MRE-Lab-UMD/arts/docs/decisions/07_simulation.md

# Decision 7 — Simulation

> **Role: decision record.** Moved verbatim from `AGENTS.md` on 2026-10-26 so the agent
> onboarding file stays short; `AGENTS.md` keeps a summary and links here.
> Words like "above", "below" or "this file" in the text refer to
> `AGENTS.md` as it was laid out before the move.

7. **Simulation:** Isaac Lab 3.0 with Newton physics backend (Linux Foundation, Apache-2.0),
   exposing the identical ROS 2 topic surface as the real patient cart; sim/real switch at the
   driver layer only. Haply has a first-party Isaac Lab integration for sim teleop.
