MRE-Lab-UMD/arts/docs/arts_architecture_proposal.html

# ARTS Software Architecture Proposal

From a dual-arm open resection system (ROS 2 Humble + OROCOS) to ARTS — a replicable, <$150k, fully open 3-arm laparoscopic platform for surgical autonomy research. Grounded in the v1.4 codebase inventory · August 2026.

## Key decisions at a glance

# | Decision | Recommendation | Why

1 | OROCOS RTT | Retire it. Propose ARTS as a ROS 2 / Slicer / NVIDIA stack. | rtt_ros2_integration has zero formal releases and a tiny community; the determinism it provides is reproducible with ros2_control chainable controllers, which every contributor already knows.
2 | Workspace & repo layout | Standard ROS 2 overlay chain: /opt/ros/humble (base underlay) → categorized middle overlays (ur_ros2_ws, flir_ros2_ws, slicer_ros2_ws, atracsys_ros2_ws, isaac_ros2_ws, oem_ros2_ws) → arts_ros2_ws on top → application overlays. Two trees: the git repo holds only recipes, .repos manifests, and first-party source; the ~142 GB of SDKs, third-party source, and build output lives in a machine-local mirror at ~/arts_local. Users source a single setup.bash. | Third-party stacks ship as their own workspaces and should stay in their native structure, pinned and rarely rebuilt. arts_ros2_ws stays small and fast to iterate; end users never see the middle-overlay details. Packages follow ROS 2 naming convention (arts_description, arts_driver, arts_controllers, …) — carts are deployment profiles, not code boundaries.
3 | ROS distro | Stay on ROS 2 Humble (Ubuntu 22.04) through 2026–27, then migrate directly to the 2026 LTS (Lyrical, supported to 2031) around summer 2027 once it has matured. Skip intermediate distros entirely. | Humble is in its most reliable years right now (2022–2027 support window) and matches every pinned driver in the current stack. One planned migration to a fresh 5-year LTS beats two migrations through Jazzy.
4 | Distribution | Docker-first (compose profile per cart) + a small host-setup script; keep a bare-metal install path generated from the same layers. | Clock discipline, udev, and NIC tuning cannot live in a container; everything else can and should.
5 | Time & recording | One PTP (IEEE 1588) clock domain; hardware-triggered stereo FLIR pair; everything into rosbag2 MCAP with device hardware timestamps. | Sync is decided at timestamp origin, not at save time. Once stamps are PTP-correct, "bridge to ROS then save" vs "save directly" stops mattering.
6 | Command API | Follow plain ROS 2 naming conventions (geometry_msgs / sensor_msgs types, ros2_control controller naming, REP-144-style topic names). No CRTK / dVRK vocabulary. | ARTS is deliberately independent of dVRK (no support path for da Vinci Xi/X/SP/5 instruments there, and no reliance on company donations). ROS 2 conventions are the common denominator that Slicer and NVIDIA tooling already speak.
7 | Simulation | Isaac Lab 3.0 with the Newton (Linux Foundation, Apache-2.0) physics backend, exposing the same ROS 2 interface as the real patient cart. | Sim/real switch happens at the driver layer; teleop and autonomy code cannot tell the difference.
8 | GPU vs RT kernel | Keep the RT control path free of any GPU dependency: GPU work (perception, encoding, learning) runs in separate processes or a second PC. PREEMPT_RT becomes an optional optimization, not a prerequisite. | NVIDIA drivers only gained working PREEMPT_RT compatibility in release 590.44.01 (late 2025) and it is still not officially supported. Decoupling means the system never depends on that fix.
9 | Dev methodology | Module-first, in Docker on the current PC. Every hardware module gets its own compose profile containing just its driver + ROS wrapper, a standard benchmark harness, and a committed baseline (rate mean ± std, CPU, RAM, disk/net I/O, drops). Integration climbs a ladder — module solo → pairs → full cart — re-running the identical benchmarks at every rung. | Isolating modules is how problems get located in big-system integration. Identical benchmarks at each rung make resource contention visible the moment it appears, instead of surfacing as mystery jitter in the full system.

## Target runtime architecture

Everything above the real-time core is soft real-time and replaceable; everything inside it runs in a single process on the patient-cart PC so all three arms share one deterministic update cycle.

Autonomy

BehaviorTree.CPP surgical workflows

Perception: stereo depth, SAM2, NIR, occupancy

Resection / task planners (from nephrectomy_ws)

Teleoperation (surgeon console)

2× Haply Inverse3 via Inverse Service (polled at 500 Hz)

Clutch, motion scaling, camera-frame mapping

Footswitches: energy, camera, record marks

Imaging (3D Slicer)

SlicerROS2 bridge

Pre/intra-op model registration

Plans published as ROS 2 targets

plain ROS 2 topics: geometry_msgs Cartesian targets, joint commands, jaw commands, measured states

Real-time control core — two rate-grouped controller_managers, SCHED_FIFO + CPU shielding (PREEMPT_RT optional)

500 Hz manager: both UR5e tool arms + instrument wrists — teleop follower → RCM + collision QP (pinocchio + proxsuite) → Ruckig → per-arm forward_position

125 Hz manager: UR5 CB3 camera arm. Rates cannot mix in one manager: ur_robot_driver's read() blocks on the RTDE stream, so a shared loop would be dragged to the slowest arm

Cross-manager joint states mirrored via RT-safe buffers for the collision QP (≤ 8 ms staleness — fine for collision margins, camera arm moves slowly)

Safety: arm–arm distance constraints as QP velocity dampers; e-stop aggregation as last resort

ros2_control hardware interfaces / device SDKs

Motion drivers

ur_robot_driver ×3 (RTDE: 500 Hz UR5e, 125 Hz UR5 CB3)

Tool drive: da Vinci X disc motors in custom adapters

Sensing drivers

2× FLIR via Spinnaker driver — PTP-stamped, HW-triggered pair

Laparoscope light source status

Aux / energy drivers

ESU + footswitch MCU (micro-ROS)

Vacuum (EPick), suction, irrigation, smoke evacuator

hardware

Patient cart hardware

Vention pedestal · 1× UR5 + 2× UR5e · da Vinci X laparoscope head + 2 FLIR cameras · 2× da Vinci X instruments via custom UR adapters · Karl Storz trainer box

Simulation twin

Isaac Lab 3.0 (Newton backend) spawns the same patient cart from the shared URDF/USD assets and exposes the identical ROS 2 topic surface. The teleop and autonomy layers connect to sim or real by launching a different driver profile — no code changes.

Data recording plane

A recorder taps every layer over ROS 2 into MCAP bags. All headers carry device hardware timestamps in one PTP clock domain, so offline alignment for SRT-H / LeRobot datasets is exact rather than approximate.

## Retiring OROCOS — what replaces each piece

Today the OROCOS mid-level controller (the v1.4 controller) runs a 100 Hz activity with Reflexxes Type II and KDL, deployed through a .ops script, and requires hand-built RTT typekits for every message plus a serialized single-worker build of orocos_ws. Each RTT feature maps cleanly onto a maintained mainstream replacement:

OROCOS feature used in v1.4 | Replacement in ARTS
TaskContext with 100 Hz periodic activity | controller_manager update loop at 250–500 Hz, SCHED_FIFO thread
Reflexxes Type II online trajectory generation | Ruckig (community version, actively maintained, jerk-limited OTG)
KDL FK / IK solvers | Pinocchio (analytic derivatives, needed anyway for the RCM/collision QP); ur_ikfast kept for analytic IK
RTT ports + typekits for zero-serialization dataflow | Chainable-controller interfaces inside one process; intra-process composable nodes elsewhere — no typekit generation ever again
deployer + .ops deployment scripts | ROS 2 launch + lifecycle nodes
OCL NetCDF reporting | rosbag2 MCAP
Lock-free RT-safe buffers | realtime_tools RealtimeBuffer / RealtimeBox

The nuance worth keeping What OROCOS actually bought you was deterministic in-process dataflow between components. Preserve that property architecturally — keep each servo pipeline in-process with chained controllers, in two rate-grouped controller_managers (500 Hz for the UR5e pair, 125 Hz for the CB3 camera arm; the UR driver's blocking RTDE read forbids mixing rates in one loop) — rather than by keeping RTT. Note that the orocos_kdl kinematics library is a separate, still-maintained project; using or dropping it is independent of dropping the RTT runtime.

Why not keep RTT? To be clear, OROCOS RTT and rtt_ros2_integration are fully open source (Apache-2.0) — the objection is purely maintenance and community. rtt_ros2_integration has no formal releases and a contributor pool of a handful of people, and it is the single biggest build complexity in the legacy installer today (serialized single-worker builds, hand-generated typekits for every message). For a release aimed at replication by other labs, every dependency should be apt/rosdep-installable and familiar to contributors.

Determinism, the NVIDIA driver, and the RT kernel Important decoupling: neither OROCOS nor ros2_control makes timing deterministic by itself — both just run SCHED_FIFO priority threads, and the jitter floor comes from the kernel underneath. So the RTT-vs-ros2_control choice is orthogonal to the NVIDIA-on-PREEMPT_RT problem. That problem now has three workable answers, in order of preference: (1) keep the control path GPU-free so the control PC does not need the NVIDIA kernel module at all (GPU perception on a second machine or a non-RT box); (2) run a single PC without PREEMPT_RT — a lowlatency/PREEMPT_DYNAMIC kernel with SCHED_FIFO threads and isolcpus CPU shielding holds sub-millisecond jitter, which servoj's lookahead smoothing absorbs easily at 500 Hz; (3) if hard RT is truly wanted on the GPU machine, NVIDIA driver 590.44.01+ contains the locking fix that previously deadlocked PREEMPT_RT (unsupported officially, but functional). ARTS should be designed to work under option 1 or 2 and treat PREEMPT_RT as an optional tuning step.

## Workspace layering & repo layout

ARTS keeps the proven v1.4 layering: a binary base underlay, categorized middle overlays for third-party stacks that ship in their own native layout, one first-party workspace on top, and per-project application overlays above that. End users never see the middle-overlay details — they source one setup.bash and build on top.

        application overlays — one per project / user
   imitation_learning_ws · cao_resection_ws · your_project_ws …
     └─ source ~/arts/arts_ros2_ws/install/setup.bash — nothing else needed
                              ▲
  arts_ros2_ws                all first-party arts_* packages (the top overlay)
                              ▲
  middle overlays — categorized, version-pinned, rarely rebuilt, built one per
     ur_ros2_ws · flir_ros2_ws · slicer_ros2_ws · atracsys_ros2_ws ·
     isaac_ros2_ws · oem_ros2_ws   (orocos_ws: retired)
     fresh `env -i` shell; each depends only on the base, never on a sibling
                              ▲
  /opt/ros/humble             base underlay (binary install)

A terminology note that matters for newcomers: in ROS 2, underlay conventionally means the base installation you build on top of (/opt/ros/humble). The categorized third-party workspaces in the middle are therefore called middle overlays — each is an overlay of the base and an underlay for arts_ros2_ws. Calling them "underlays" invites confusion with the base, so ARTS does not.

Three rules keep this modular instead of fragile: (1) middle overlays never depend on each other, so they rebuild independently — enforced by building each in a fresh env -i shell that sources only the base, exactly as the legacy installer does; (2) every middle overlay is defined by a version-pinned vcstool .repos manifest stored in the arts repo (under middle_overlay_ros2_wss/), so the whole chain is reproducible with one assemble script; (3) if a middle overlay is ever rebuilt, everything above it rebuilds too (ABI safety) — acceptable because pinned overlays change perhaps once a year. A bonus below in Distribution: each middle overlay maps one-to-one onto a cached Docker image layer.

There are two trees, and conflating them is the most common source of confusion. The git repo holds only text — install recipes, vcstool manifests, and first-party source (tens of MB). Everything heavy — OEM SDK trees, third-party source, and build artifacts, roughly 142 GB on the current development PC — lives in a machine-local tree at ~/arts_local that is reconstructed from those recipes and never committed. The two trees mirror each other by folder name, so ~/arts/oem_drivers/spinnaker/install.sh installs into ~/arts_local/oem_drivers/spinnaker-4.2.0.88/.

~/arts/                            ← THE GIT REPO — text only, tens of MB
├─ oem_drivers/                    manufacturer drivers/SDKs FOR PHYSICAL HARDWARE.
│  │                               Criterion is "a physical component exists", not license:
│  │                               Intel's librealsense is open source but belongs here;
│  │                               Slicer does not. Recipes only, never the SDK.
│  ├─ spinnaker/                   install.sh + VERSION   (FLIR cameras)
│  ├─ haply/                       install.sh + VERSION   (Inverse3 service, closed binary)
│  ├─ fusiontrack/                 install.sh + VERSION   (Atracsys optical tracker)
│  └─ zivid/ · clarius_cast/ · librealsense/
├─ open_source_software/           open-source NON-ROS software built from source
│  ├─ coal/ · pinocchio/ · proxsuite/ · ruckig/      build.sh + pinned VERSION each
│  └─ slicer/ · plus_toolkit/
├─ middle_overlay_ros2_wss/           third-party ROS 2 workspaces — manifests + build scripts
│  ├─ ur_ros2_ws/                   ur_ros2.repos       (UR driver + description, pinned tag)
│  ├─ flir_ros2_ws/               flir_ros2.repos   (FLIR spinnaker driver, image_common)
│  ├─ slicer_ros2_ws/              slicer_ros2.repos   (SlicerROS2)
│  └─ oem_ros2_ws/                 oem_ros2.repos      (loose wrappers with no ws of their own:
│                                                  zivid-ros, robotiq, realsense-ros,
│                                                  micro-ROS agent)
├─ arts_ros2_ws/                        THE top overlay — same shape as a middle overlay,
│  └─ src/                         builds in place (build/ install/ log/ gitignored)
│     ├─ arts_interfaces           msgs + srvs + actions (single package, ROS 2 convention)
│     ├─ arts_description          URDF+SRDF, tools, trainer box, calib; USD export for sim
│     ├─ arts_calibration          procedures + committed results → feeds arts_description
│     ├─ arts_driver               bringup launch + configs with per-component toggles
│     ├─ arts_controllers          chainable ros2_control: servo, RCM, teleop follower
│     ├─ arts_embedded/            FIRST-PARTY drivers — no third-party ROS driver exists
│     │  ├─ arts_dv_tool_driver        da Vinci X instrument disc drive (adapter motors)
│     │  ├─ arts_esu               micro-ROS bridge to ESU / footswitch MCU
│     │  └─ --- (haply bridge moved to oem_ros2_ws as haply_inverse3_ros2) WebSocket ↔ ROS 2 bridge
│     ├─ arts_utilities/
│     │  ├─ arts_kinematics        pinocchio models, ur_ikfast, instrument kinematics
│     │  ├─ arts_safety            arm–arm collision monitor/predictor, e-stop aggregation
│     │  ├─ arts_teleop            clutch, scaling, camera-frame mapping, input mapping
│     │  ├─ arts_record            MCAP recording profiles, footpedal-triggered marks
│     │  └─ arts_datasets          MCAP → LeRobot / SRT-H export + sync tooling
│     ├─ arts_sim                  Isaac Lab env, Newton assets, sim driver shim
│     └─ arts_slicer               SlicerROS2 modules, ultrasound, registration
├─ example_app_ros2_ws/                 ONE example application overlay on top of arts_ros2_ws
├─ deploy/                         module scripts, dockerfiles, compose, host_setup.sh, CI
├─ docs/                           build guide, BOM (<$150k), calibration, ADRs, benchmarks
└─ reference/                      gitignored symlinks; DELETE before open-sourcing

~/arts_local/                      ← MACHINE-LOCAL — ~142 GB, never in git
├─ oem_drivers/                    spinnaker-4.2.0.88/ · fusiontrack_v4.7.1/ · zivid-2.14.0/
├─ open_source_software/           coal/ · pinocchio/ · Slicer-Superbuild-Release/
└─ middle_overlay_ros2_wss/           ur_ros2_ws/{src,build,install,log} · flir_ros2_ws/{...}
                                   atracsys_ros2_ws/{...} · isaac_ros2_ws/{...} · oem_ros2_ws/{…}

Every non-package directory in the repo carries a COLCON_IGNORE marker so a colcon build from arts_ros2_ws does not descend into workspaces that must be built separately. This is mandatory in reference/ in particular: without it colcon follows the v1.4 reference symlink and attempts to build the entire previous-generation system. Note that COLCON_IGNORE is not .gitignore — those directories are fully git-tracked.

Two naming decisions worth stating explicitly. First, there is no arts_ur or arts_camera_flir package: UR and FLIR already have maintained third-party ROS drivers that arrive through the middle overlays, so what ARTS adds is launch and configuration, which lives in arts_driver. Only hardware with no ROS driver at all — the da Vinci disc drive, the ESU microcontroller, the Haply service bridge — earns a first-party package under arts_embedded/ (custom PCB + ESP32/micro-ROS bridges). Second, procedure-specific autonomy (perception, resection planners, task state machines) deliberately does not live in arts_ros2_ws; it belongs in application overlays. The prior system mixing ismr2024 and iros_2024_nephrectomy into its main repo is the pattern this avoids, and it is what makes the platform cleanly releasable.

### Dependency pinning policy

An unpinned open-source dependency will break the build between machines or overnight. This is not hypothetical for this lab: during prior development, collision-detection code that built successfully one evening failed the next morning on a second PC because coal's API had changed upstream in between. With more than a hundred libraries in the chain, tracking HEAD is not viable — the rule is to pin a release that is verified to build, and stay on it until a concrete problem forces a bump.

Dependency class | Pinned in | Example
Third-party ROS packages | middle_overlay_ros2_wss/<ws>/<ws>.repos | Universal_Robots_ROS2_Driver @ tag 2.2.15
Open-source non-ROS libraries | open_source_software/<lib>/VERSION | coal @ full commit hash
OEM SDKs | oem_drivers/<sdk>/VERSION + archive mirrored to ~/arts_local | Spinnaker @ 4.2.0.88
apt packages | deploy/modules/<module>.sh | libeigen3-dev=3.4.0-2ubuntu2
Python packages | requirements.txt beside the consuming package | torch==2.3.1

Two rules deserve emphasis. Never a branch: version: main or devel in a .repos file is banned; use a tag or, preferably, a full commit hash. Non-ROS C++ libraries are pinned too — coal, pinocchio, proxsuite, and Ruckig each get their own build recipe, and any transitive FetchContent(… GIT_TAG main) hidden inside a dependency's CMakeLists is overridden explicitly rather than inherited. Bumping a pin is a deliberate, benchmarked act: change the version, rebuild, re-run that module's benchmark, and commit the new baseline beside the old one.

### Cart naming

Keep the da Vinci-familiar names — they are instantly understood by every clinical and surgical-robotics reader: Patient Cart, Surgeon Console, Vision Cart. Inventing new names would cost recognition and buy nothing. In code they appear only as deployment profiles: cart-patient, cart-surgeon, cart-vision.

## Data recording & synchronization

### One clock domain, decided in hardware

Source | Rate | Sync mechanism | Timestamp origin
2× FLIR cameras (stereo laparoscope) | 30–60 fps | IEEE 1588 PTP slaves to the main PC; L/R pair fired by a shared hardware trigger line (or primary→secondary GPIO) | Camera hardware timestamp, already in PC clock domain
UR5e ×2 (RTDE) | 500 Hz | Driver stamps on receipt; jitter « 2 ms over dedicated NIC | PC receive time (fine at this rate)
UR5 CB3 (RTDE) | 125 Hz | Same | PC receive time
Haply Inverse3 ×2 | 500 Hz poll | Local service on the same PC → localhost latency ~0 | Bridge receive time
ESU / footswitch MCU | event + 100 Hz status | micro-ROS agent stamps at bridge | Agent receive time
Tool drive, EPick, pumps | ≤ 100 Hz | ROS 2 native | Node publish time

Answer to the "bridge to ROS and save, or just save?" question Bridge to ROS and record with rosbag2/MCAP. The thing that makes camera data hard to sync is not where you save it — it is where the timestamp comes from. With PTP-disciplined hardware stamps written into header.stamp by the Spinnaker ROS driver (as a composable node with intra-process transport, so frames are not copied), the bag is exactly as well-synchronized as a custom saver, and you keep one uniform recording, replay, and tooling path for every sensor in the system.

### Image bandwidth budget (the dominant cost)

Example at 1920×1200 @ 60 fps per camera — adjust to the exact FLIR model:

Format | Per camera | Both cameras | Verdict
Bayer 8-bit raw (debayer offline) | ~138 MB/s | ~276 MB/s | Preferred if a dedicated NVMe is available — lossless, trivially sustained by PCIe-4 SSDs
Debayered RGB8 | ~415 MB/s | ~830 MB/s | Never record this — 3× the data for zero information gain
Per-frame JPEG (GPU nvJPEG, q≈90) | 8–15 MB/s | 16–30 MB/s | The fallback when storage is constrained; still frame-random-access for training
H.264/H.265 (NVENC) | 4–8 MB/s | 8–16 MB/s | Smallest, but GOP structure hurts random access for imitation-learning dataloaders — archival copies only

### Recording architecture

Humble caveat: MCAP is supported but not the default rosbag2's MCAP plugin is officially released for Humble (ros-humble-rosbag2-storage-mcap) but is not part of the desktop/base variants and sqlite3 stays Humble's default — MCAP only became the default in Iron. So: install the plugin explicitly in every recording image and installer, always pass -s mcap to ros2 bag record, and put writer tuning (chunk size, zstd presets) in a shared --storage-config-file YAML. Playback needs no flag — rosbag2 auto-detects the format when reading.

Run two recorder processes into one session directory: bag A for robot/teleop/tool/energy state (~10 MB/s total — three arms at 500 Hz is trivial) and bag B for images, writing to a dedicated NVMe. MCAP with zstd for bag A; images stored uncompressed-by-rosbag (already Bayer or JPEG). Footpedal events publish "episode start/stop" marks that the recorder logs, so demonstrations segment themselves. Offline, arts_datasets aligns streams by hardware stamps and exports LeRobot-format episodes for SRT-H training.

## Distribution: Docker-first, host-setup second

The install-script pain from the prior system (OEM drivers pinned to specific releases, deps breaking overnight) is exactly what container images solve: users pull a frozen, tested image instead of re-resolving the world. But a container cannot provide kernel or clock discipline, so the design is a thin host layer plus fat images. The workspace layering maps one-to-one onto Docker image layers: each middle overlay (ur_ros2_ws, flir_ros2_ws, slicer_ros2_ws, oem_ros2_ws) is built in its own layer, so changing arts code rebuilds only the top layer while every middle overlay stays cached.

Stays on the host host_setup.sh

· CPU isolation (isolcpus for the control core); PREEMPT_RT kernel optional per decision 8

· ptp4l / phc2sys PTP grandmaster config

· NIC tuning: jumbo frames, receive buffers for GigE Vision

· udev rules (Haply, MCU serial, cameras), NVIDIA driver, nvidia-container-toolkit

Lives in containers GHCR images

· arts-control — net=host, CAP_SYS_NICE, /dev access; runs controller_manager

· arts-vision — NVIDIA runtime, Spinnaker, perception models

· arts-teleop / arts-recorder / arts-slicer (X11) / arts-sim (Isaac Lab)

· devcontainer for contributors, same base image as release

Redistribution check before release Spinnaker SDK, the Haply Inverse Service, and Zivid debs have OEM licenses that may not permit baking into a public image. The pattern that always works: the Dockerfile takes the vendor archive as a build argument, the repo documents the (free) download step, and your lab additionally keeps the current Software/-style vendored mirror for internal builds. Everything else should come from rosdep/apt with versions pinned in the image.

Keep a bare-metal install path, but generate it from the same Dockerfile layers (or document the Dockerfile as the canonical install recipe) so the two never drift apart the way the existing install docs and scripts already have.

### Module-first development workflow

The host stays minimal — kernel, NVIDIA driver, docker + nvidia-container-toolkit, PTP daemons — and every module is developed and benchmarked in its own compose profile with only its driver and ROS wrapper installed. The benchmark harness is a contract every driver package honors: a bench launch file plus an offline analyzer that reports achieved rate (mean ± std from MCAP stamps), CPU%, RSS, disk/network I/O, and drop count. Each result is committed under docs/benchmarks/ together with the image digest it ran on, so baselines are reproducible and regressions are diffable.

Integration then climbs a ladder, re-running the identical benchmarks at every rung: (1) module solo; (2) contention pairs — both cameras together, cameras + recorder, arms + recorder; (3) full patient cart; (4) full system with teleop and display. Each module also gets a resource budget up front (CPU cores from the isolcpus map, NIC allocation for GigE cameras, NVMe lane for the image bag) so a benchmark passes against its budget, not just in isolation.

PREEMPT_RT + NVIDIA + isolcpus — single-PC RT PROVEN (2026-08-05) Ubuntu Pro realtime kernel 5.15.0-1081-realtime installed as a second GRUB entry (generic 6.8.0-136 kept). NVIDIA driver 595.84 installed via apt install nvidia-driver-595 (userspace) + IGNORE_PREEMPT_RT_PRESENCE=1 DKMS bypass (made permanent in /etc/dkms/framework.conf; packages held via apt-mark hold). CPU isolation: isolcpus=4,5,10,11 nohz_full=4,5,10,11 rcu_nocbs=4,5,10,11 in GRUB. cyclictest result (5 min, CPU saturated + NVIDIA GPU rendering via PRIME offload): worst-case latency on isolated cores = 190 µs (avg 4–5 µs). That is 9.5% of the 500 Hz control period (2 ms) — well within budget. Decision 8 is answered: single-PC RT is the path forward; the two-PC and lowlatency-baseline fallbacks are retired. Production workstation with 16+ cores will have even more isolation headroom.

## New components not in the prior system

Software remote center of motion (RCM) arts_controllers

Formulate the servo loop as a small QP solved every cycle (pinocchio for kinematics + derivatives, proxsuite as solver): primary task tracks the tool-tip pose command; equality/soft constraint pins the instrument shaft to the calibrated cannula point; inequality constraints enforce joint limits, velocity limits, and arm–arm minimum distance. This is the standard modern replacement for the mechanically-constrained RCM of the da Vinci, runs comfortably at 250–500 Hz for three 6-DoF arms, and subsumes the current Reflexxes+KDL pipeline. Calibrate each RCM point from the cannula pose in the trainer box; a later refinement can estimate the true fulcrum from interaction forces.

Real-time arm–arm collision detection and prediction arts_safety

Approximate arms, adapters, and instrument shafts as capsules and query distances with coal (already vendored in the prior system) at ≥200 Hz. Predict by rolling joint states forward 100–300 ms at current velocities. Feed the results into the same QP as velocity-damper inequality constraints, so arms smoothly slow and deflect near contact instead of e-stopping — essential when all three elbows crowd over one trainer box while the surgeon's attention is at the tool tips. Hard e-stop remains as the escalation path.

Haptic teleoperation arts_teleop

The Inverse3 talks through the Haply Inverse Service — an OEM driver in the same category as Spinnaker or the UR controller firmware: a closed binary with a fully documented, open JSON-over-WebSocket API and open-source clients (Haply's Rust crate, Isaac Lab's Python HaplyDevice class). Every existing open wrapper sits on this service, so ARTS wraps it too: a thin bridge node polls it at 500 Hz — matched to the UR5e RTDE rate; the service's multi-kHz capability is unnecessary here since the service answers one state per command sent. The teleop layer implements clutching, 3:1–5:1 motion scaling, and mapping into the camera frame (so surgeon hand motion matches the laparoscope view), then publishes Cartesian target topics consumed by the RT core. Operator inputs beyond the cursor need an explicit, configurable mapping layer: VerseGrip buttons and a programmable 3-pedal footswitch are assigned to clutch, camera control, instrument switching, energy activation, and recording marks via a single mapping file (not hardcoded). Haply's first-party Isaac Lab integration gives sim teleop nearly for free. One dependency note for the docs: unlike the UR driver (open PC-side code over a documented wire protocol), the Inverse3 serial protocol is not public, so the service binary is a hard dependency.

da Vinci X instrument drive arts_dv_tool_driver

The custom UR–da Vinci adapters need a 4-motor disc drive per instrument. Expose it as an ordinary ros2_control joint interface (wrist pitch/yaw + jaw) chained into the same controller_manager so tool wrist and arm motion are coordinated in one cycle. ARTS defines and publishes its own instrument kinematics/coupling files for da Vinci X instruments — deliberately independent of dVRK, which has no support path for Xi/X/SP/5-generation tools. Existing dVRK definitions serve as a cross-check reference at most.

Energy / footswitch microcontroller arts_esu

Run micro-ROS on the MCU that sits between footswitches, the ESU back panel, and the PC. It publishes activation state (who requested energy, when it actually fired) and accepts activation commands from software — both directions land in the same bag, so imitation learning gets exact energy-on/off labels aligned with images and kinematics.

Stereo display path (GOOVIS HMD) surgeon console

The GOOVIS is an HDMI display: render the two FLIR streams side-by-side with a dedicated low-latency GStreamer/GPU path directly from the camera driver, not through RViz. Target glass-to-glass latency under ~100 ms; this path is independent of the recording path so display never competes with the recorder.

## Evaluation & benchmarking (ISMR target)

Every claim about the system gets a measurable, reproducible test — and where a comparison to dVRK or clinical systems is meaningful, the measurement method is independent of the software stack (external cameras, offline analysis of recorded stamps) so numbers are directly comparable across platforms.

### Benchmark anchors from SOTA open platforms

Platform | What they reported | ARTS comparison experiment
dVRK-Si (JHU/Vanderbilt, ISMR 2025) | PID control for all arms at 1.5 kHz with 0.01 ms std; digital current-loop step response < 1 ms. System/electronics paper — no task or latency metrics. | Report servo-loop rate + jitter with identical statistics; note the architectural caveat honestly (UR joint servos are internal to the arm — ARTS measures the command-path loop, dVRK-Si measures its own joint PID).
MOPS (SDU, ISMR 2021) | Vision-in-loop trajectory-following error 1.2 mm / 0.3° (UR5e arm), 2.7 mm / 0.7° (UR5 arm); autonomous needle pick-up 28/30; contact detection at 1.3 N. No latency, no RCM deviation reported. | Replicate their vision-in-loop protocol (stereo-tracked marker, taught trajectory) for a directly comparable end-to-end number — MOPS is ARTS's closest ancestor (UR arms + EndoWrist adapters + software RCM).
Open-source laparoscopic platform (under review, 2026) | Kinematic RCM deviation median 0.035–0.079 mm (phantom → in vivo); SPARC/LDLJ smoothness ≈ JIGSAWS experts; 85% autonomous policy success on bowel retraction. | Report kinematic RCM deviation with their exact definition, and SPARC/LDLJ computed from ARTS demo recordings against JIGSAWS + their published values.

ARTS differentiator measurements None of the three platforms report motion-to-motion teleoperation latency or externally measured (non-kinematic) accuracy. ARTS's external latency rig and the Atracsys fusionTrack ground-truth sessions are therefore both a contribution and a shield against the obvious reviewer question "your RCM number is kinematic — what is it physically?"

Category | Metric & method | Target
Latency | Teleop motion-to-motion: an external 240 fps camera films the Inverse3 handle and the robot tool in the same frame; latency = frame count between motion onsets. Stack-independent, same method used in dVRK literature. | ≤ 100 ms end-to-end
Latency | Glass-to-glass video: LED flash in the surgical scene filmed together with the HMD/monitor output by the same high-speed camera; frame-delta gives display-path latency. | ≤ 100 ms
Control | Servo loop health: cycle-time jitter (mean ± std) and deadline misses from controller_manager diagnostics over a 1 h session. | 0 missed deadlines; jitter < 10% of cycle period
Control | RCM deviation, two definitions: (a) kinematic — FK distance of the shaft line to the commanded RCM point, the same definition the open laparoscopic platform uses (their median: 0.035–0.079 mm); (b) physical — measured against the calibrated cannula including calibration error. Both logged through ≥ 30 min of teleoperation with drift slope. | (a) ≤ 0.1 mm median; (b) ≤ 1 mm RMS, ≤ 2 mm peak, no drift
Control | Master–slave tracking fidelity: RMS Cartesian error between the scaled master trajectory and the measured tool trajectory at nominal teleop speeds. | Report; goal ≤ 1 mm RMS
Control | Trajectory smoothness: SPARC and LDLJ computed offline from recorded teleop trajectories (downsampled to 5 Hz for fair comparison) against JIGSAWS expert demonstrations and the open platform's published values. Zero extra experiment time — pure post-processing of demo recordings. | Within the expert JIGSAWS range
Accuracy | Vision-in-loop trajectory following (MOPS protocol): stereo-tracked marker on the instrument, mean end-to-end pose error along a taught trajectory — directly comparable to MOPS's numbers. | ≤ 1.2 mm / 0.3° (match or beat MOPS's better arm)
Accuracy | External ground truth: Atracsys fusionTrack optical tracker (SDK already vendored in the v1.4 reference snapshot) physically measures tool-tip accuracy and RCM deviation — validates the kinematic numbers. | Report; no SOTA platform publishes this
Data pipeline | Recording rate consistency: per-topic achieved frequency (mean ± std) computed offline from MCAP hardware stamps over 30 min full-sensor-load sessions. Nominal rates are deliberately set at ~70% of each module's ceiling — consistent, not maximal. | ≥ 99% of nominal on every topic; zero dropped robot samples
Data pipeline | Synchronization accuracy: L/R stereo hardware-stamp skew (trigger-limited) and camera-to-robot clock alignment from PTP offset logs. | L/R skew < 1 ms; PTP offset < 1 µs
Safety | Collision avoidance: scripted near-collision teleop scenarios with three arms over the trainer box; log minimum inter-arm distance and contact count. | 0 contacts; minimum distance never below the QP margin
Human factors | NASA-TLX weighted workload after standardized FLS peg-transfer sessions, N ≥ 5 operators. | Weighted score ≤ 50
Human factors | Task performance: FLS peg-transfer completion time and error rate, compared against published dVRK and da Vinci teleop baselines. | Within the range of published dVRK results
Surgical function | Advanced da Vinci X instrument functions on ex vivo porcine tissue: monopolar cut & coag, bipolar coagulation, vessel sealing (with burst-pressure check), stapler firing (with staple-line leak check). | All four functions demonstrated with predefined per-task success criteria
System | Reliability and replicability: one uninterrupted 2 h teleop session without software restart; fresh-machine install from README by an outside user. | No restarts; teleop-in-sim within one day; BOM < $150k

Hard milestone: funder demo at T+2 months (~early Oct 2026) Teleoperated partial nephrectomy on a hydrogel phantom using a monopolar curved scissors and a bipolar fenestrated forceps. The recording pipeline must be complete beforehand so the demo is captured end-to-end as the example dataset for the ISMR paper. Demo-critical path = phases 0–4 (those two instruments + monopolar/bipolar energy specifically); simulation (phase 5) and the Docker release (phase 6) may slip past the demo. Stapler and vessel-sealing tests come after the demo.

Three-month path to an ISMR submission Month 1 — phases 0–2 plus the external latency rig (camera + LED, built once, reused forever). Month 2 — phases 3–4, closing with the funder demo; the automated metrics (latency, loop health, RCM drift, recording rates, sync) collect themselves during development sessions. Month 3 — NASA-TLX study, remaining tissue tests, writing, and the anonymized project page. If time runs short, the minimal publishable set is: system description + latency + recording/sync + RCM + the demo task with NASA-TLX; stapler and vessel-seal become qualitative demonstrations or future work.

Double-blind review logistics The private GitHub repo stays private and under a personal account — never linked from the submission. For review, publish an anonymized project page (fresh GitHub org/Pages with authors redacted, in the style of recent open-platform papers) and share code through an anonymized capsule (e.g. anonymous.4open.science). De-anonymize both after acceptance. Reviewers tracing a repo to the author is a known desk-rejection cause.
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
