MRE-Lab-UMD/arts/docs/dependency_pinning.md

# Dependency pinning policy — full text

> **Role: reference.** Moved verbatim from `AGENTS.md` on 2026-10-26 so the agent
> onboarding file stays short; `AGENTS.md` keeps a summary and links here.
> Words like "above", "below" or "this file" in the text refer to
> `AGENTS.md` as it was laid out before the move.

An unpinned open-source dependency WILL break the build between machines or overnight; this
happened in the prior system when coal's API changed between two builds a day apart. With >100
libraries in the chain, chasing HEAD is not viable. Pin a verified release and stay on it
until a concrete problem forces a bump.

Five rules, one home per dependency class:
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
