MRE-Lab-UMD/arts/docs/bom/bom.csv

cart | category | item | vendor | part_number | qty | unit_price_usd | price_basis | url | notes
patient | structure | 3-arm pedestal (assembled; arm mounts and casters included) | Vention | MF-RB-524807 | 1 | 16541.55 | list | https://vention.com/designs/robotic-surgery-triple-overhead-robot-stand-524807 | Vention parts-only price, no discount: 15,120.50 for the pedestal design plus 1,421.05 for the later pedestal reinforcement (PI, 2026-11-02), self-assembled like the 80/20 console. Order from the public design link rather than the ~300 individual parts. Excludes freight. The public design specifies 3x UR5e and its page total includes them; the arms are separate rows here.
patient | arm | UR5e 6-DoF arm with controller (500 Hz tool arm) | Kinova | 029348 | 2 | 30000.00 | quote | https://vention.com/parts/universal-robots-ur5e-collaborative-robot-arm-2445 | Typical standard quoted price per arm, subject to each institution's quote: the PI quoted the UR5e from four independent vendors, the designated channel among them, all at about 30,000 before any special discount; no vendor publishes an online price. Upper bound: 34,527.00 (Vention shows it for a UR5e marked Obsolete, 2026-11-02). Buy through the designated channel: see the Procurement constraints section of this directory's README. Ex-Works, freight extra.
patient | arm | UR5e 6-DoF arm with controller (camera arm) | Kinova | 029348 | 1 | 30000.00 | quote | https://vention.com/parts/universal-robots-ur5e-collaborative-robot-arm-2445 | Typical standard quoted price per arm, subject to each institution's quote: the PI quoted the UR5e from four independent vendors, the designated channel among them, all at about 30,000 before any special discount; no vendor publishes an online price. Upper bound: 34,527.00 (Vention shows it for a UR5e marked Obsolete, 2026-11-02). Buy through the designated channel: see the Procurement constraints section of this directory's README. Ex-Works, freight extra. ARTS measured the camera arm on an existing UR5 CB3 at 125 Hz, which is discontinued new; a reproducer buys a UR5e.
patient | adapter | UR flange to da Vinci X/Xi instrument adapter, 5 Dynamixel disc drives (printed body, machined shafts) | ARTS (first-party) | arts-tool-adapter | 2 | 1617.19 | estimate |  | First-party design (adapter collaborator, 2026-11-02). Per adapter: bought parts 1,236.79 (designer BOM: 5x Dynamixel XC330-M288-T, U2D2 + power hub, GT2 belts and pulleys, bearings, spring plungers, 5 V 10 A supply, fasteners and inserts; optional knob parts excluded), 10 CNC shafts in 316 stainless 365.40 (5 inner + 5 outer at the qty-15 instant-quote price; 608.95 at qty 1), printed parts ~15 of filament. Design and manufacturing package in hardware/tool_adapter/ (STEP, STLs, drawings, notes); stapler parts optional.
patient | instrument | da Vinci X/Xi large needle driver, 8 mm | Intuitive Surgical (used) | 471006 | 1 | 455.00 | used | https://www.ebay.com/itm/225942413010 | Used, expired-for-clinical-use instrument from the research surplus market (eBay); 455.00 is the per-instrument figure the PI set as fair from current listings 2026-11-02. Research use only, never clinical. Instrument geometry is vendor IP; ARTS publishes kinematics only.
patient | instrument | da Vinci X/Xi monopolar curved scissors, 8 mm | Intuitive Surgical (used) | 470179 | 1 | 455.00 | used | https://www.ebay.com/itm/225942413010 | Used, expired-for-clinical-use instrument from the research surplus market (eBay); 455.00 is the per-instrument figure the PI set as fair from current listings 2026-11-02. Research use only, never clinical. Instrument geometry is vendor IP; ARTS publishes kinematics only.
patient | instrument | da Vinci X/Xi fenestrated bipolar forceps, 8 mm | Intuitive Surgical (used) | 471205 | 1 | 455.00 | used | https://www.ebay.com/itm/225942413010 | Used, expired-for-clinical-use instrument from the research surplus market (eBay); 455.00 is the per-instrument figure the PI set as fair from current listings 2026-11-02. Research use only, never clinical. Instrument geometry is vendor IP; ARTS publishes kinematics only.
patient | instrument | da Vinci X/Xi permanent cautery hook, 8 mm | Intuitive Surgical (used) | 470183 | 1 | 455.00 | used | https://www.ebay.com/itm/225942413010 | Used, expired-for-clinical-use instrument from the research surplus market (eBay); 455.00 is the per-instrument figure the PI set as fair from current listings 2026-11-02. Research use only, never clinical. Instrument geometry is vendor IP; ARTS publishes kinematics only.
patient | optics | da Vinci Si stereo endoscope, 0 deg, 12 mm | Intuitive Surgical (used) | 370892 | 1 | 150.00 | used |  | Feeds the two machine-vision cameras through the first-party stereo optical coupling (laparoscope collaborator BOM, 2026-11-02). Bought used and expired for clinical use on eBay for about 150 (PI, 2026-11-02), research use only.
patient | optics | da Vinci Si light guide, bottom panel removed | Intuitive Surgical (used) | 951026 | 1 | 50.00 | used |  | Laparoscope collaborator BOM 2026-11-02. Bought used on eBay for about 50 (PI, 2026-11-02), research use only.
patient | optics | da Vinci Si camera head drape | Intuitive Surgical (used) | 420273 | 1 | TBD | used |  | Laparoscope collaborator BOM 2026-11-02. Used, research only; price to fill in.
patient | optics | 3D-printed parts of the stereo coupling (9 parts, hardware/laparoscope/printed/) | ARTS (first-party) | arts-camera-optics | 1 | 15.00 | estimate |  | About 390 cm3 of solid part volume, under 0.5 kg of PETG/PLA at full infill; filament cost. Printed in house.
patient | camera | Blackfly S USB3 colour camera 6.3 MP | Teledyne FLIR (via Edmund Optics 11-510) | BFS-U3-63S4C | 2 | 621.00 | list | https://www.edmundoptics.com/p/bfs-u3-63s4c-c-usb3-blackflyreg-s-color-camera/40166/ | BFS-U3-63S4C-C, the model on the cart and in every benchmark; the laparoscope STEP carries a different Blackfly S body (120S4) as a shape stand-in only. Edmund Optics price 2026-11-02.
patient | camera | 50 mm C Series fixed focal length lens | Edmund Optics | 59-873 | 2 | 500.00 | list | https://www.edmundoptics.com/p/50mm-c-series-fixed-focal-length-lens/16530 | One per camera (laparoscope collaborator BOM, 2026-11-02); price read on the vendor page 2026-11-02.
patient | optics | Right-angle kinematic mirror mount, 30 mm cage | Thorlabs | KCB1C | 2 | 165.48 | list | https://www.thorlabs.com/item/KCB1C | Stereo optical coupling, laparoscope collaborator BOM 2026-11-02; price read on the vendor page 2026-11-02.
patient | optics | 1 in protected silver mirror | Thorlabs | PF10-03-P01 | 2 | 60.20 | list | https://www.thorlabs.com/item/PF10-03-P01 | Stereo optical coupling, laparoscope collaborator BOM 2026-11-02; price read on the vendor page 2026-11-02.
patient | optics | 30 mm cage plate, SM1 and C-mount double bore | Thorlabs | CP36 | 2 | 25.93 | list | https://www.thorlabs.com/item/CP36 | Stereo optical coupling, laparoscope collaborator BOM 2026-11-02; price read on the vendor page 2026-11-02.
patient | optics | External C-mount to internal SM1 adapter | Thorlabs | SM1A9 | 2 | 22.88 | list | https://www.thorlabs.com/item/SM1A9 | Stereo optical coupling, laparoscope collaborator BOM 2026-11-02; price read on the vendor page 2026-11-02.
patient | optics | SM1 lens tube 0.30 in | Thorlabs | SM1L03 | 2 | 14.07 | list | https://www.thorlabs.com/item/SM1L03 | Stereo optical coupling, laparoscope collaborator BOM 2026-11-02; price read on the vendor page 2026-11-02.
patient | optics | Right-angle prism mirror, protected silver, 25 mm | Thorlabs | MRA25-P01 | 2 | 102.94 | list | https://www.thorlabs.com/item/MRA25-P01 | Stereo optical coupling, laparoscope collaborator BOM 2026-11-02; price read on the vendor page 2026-11-02.
patient | optics | Cage assembly rod 1/2 in, 6 mm | Thorlabs | ER05 | 14 | 5.99 | list | https://www.thorlabs.com/item/ER05 | Stereo optical coupling, laparoscope collaborator BOM 2026-11-02; price read on the vendor page 2026-11-02.
patient | optics | Male M30.5 to female C-mount adapter | Edmund Optics | 33-429 | 2 | 43.25 | list | https://www.edmundoptics.com/p/male-m305-to-female-c-mount/3126/ | Stereo optical coupling, laparoscope collaborator BOM 2026-11-02; price read on the vendor page 2026-11-02.
patient | optics | M3x10 flat head screw, 18-8 | McMaster-Carr | 92125A130 | 1 | 8.77 | list | https://www.mcmaster.com/92125A130/ | McMaster sells packs: qty is ONE pack covering the 8 needed (laparoscope collaborator BOM 2026-11-02); pack price read 2026-11-02.
patient | optics | M3x55 socket head screw, 18-8 | McMaster-Carr | 91292A027 | 1 | 9.04 | list | https://www.mcmaster.com/91292A027/ | McMaster sells packs: qty is ONE pack covering the 2 needed (laparoscope collaborator BOM 2026-11-02); pack price read 2026-11-02.
patient | optics | M3x25 flat head screw, 90 deg, 18-8 (small pack) | any (e.g. McMaster-Carr, Bolt Depot) | M3x25 ISO 10642 | 1 | 10.00 | estimate |  | 2 needed. McMaster 92125A709 comes only in packs of 2000 (175.56), so a small pack from any supplier is costed instead; estimate, verify when ordering.
patient | optics | M3x30 socket head screw, 18-8 | McMaster-Carr | 91292A022 | 1 | 6.14 | list | https://www.mcmaster.com/91292A022/ | McMaster sells packs: qty is ONE pack covering the 4 needed (laparoscope collaborator BOM 2026-11-02); pack price read 2026-11-02.
patient | optics | M3 heat-set insert, brass | McMaster-Carr | 94459A140 | 1 | 10.91 | list | https://www.mcmaster.com/94459A140/ | McMaster sells packs: qty is ONE pack covering the 14 needed (laparoscope collaborator BOM 2026-11-02); pack price read 2026-11-02.
patient | optics | 8-32 x 5/8 in socket head screw, 18-8 | McMaster-Carr | 92196A196 | 1 | 11.45 | list | https://www.mcmaster.com/92196A196/ | McMaster sells packs: qty is ONE pack covering the 4 needed (laparoscope collaborator BOM 2026-11-02); pack price read 2026-11-02.
patient | optics | 1/4-20 x 7/16 in socket head screw, 18-8 | McMaster-Carr | 92196A536 | 1 | 26.14 | list | https://www.mcmaster.com/92196A536/ | McMaster sells packs: qty is ONE pack covering the 2 needed (laparoscope collaborator BOM 2026-11-02); pack price read 2026-11-02.
patient | compute | Main PC: Dell Aurora ACT1250 desktop (Core Ultra 9 285K, RTX 5080 16 GB, 32 GB DDR5, 1 TB NVMe) | Dell | ACT1250 | 1 | 3679.99 | list | https://www.dell.com/en-us/search/ACT1250 | The production workstation every benchmark ran on (E2 19 us RT latency); keyboard and mouse included. dell.com 2026-11-02, configuration act1250_so_9 (1 TB), matching ours. No dedicated image NVMe is fitted (E4 wrote to the system disk).
patient | network | Ethernet switch, 8-port unmanaged gigabit (PC and three UR controllers) | D-Link | DGS-108 | 1 | 30.00 | estimate | https://www.dlink.com/en/products/dgs-108-8-port-gigabit-ethernet-switch | Typical street price; retailer pages could not be read automatically 2026-11-02, so verify when ordering. Any unmanaged gigabit switch works.
patient | safety | IDEM Viper safety relay, 2-channel 24 V, 7 N.O., ARM HOLD manual restart | AutomationDirect | SCR73-280005 | 1 | 456.00 | list | https://www.automationdirect.com/pn/SCR73-280005 | S22 monitored manual start. Six contacts to the three UR SI pairs. Seventh unused. No second relay. See docs/modules/safeguard_stop.md.
patient | safety | 24 VDC 2.5 A DIN supply for the HOLD relay coil only | AutomationDirect | PSL-24-060 | 1 | 69.00 | list | https://www.automationdirect.com/pn/PSL-24-060 | Does not power the robots. No ground screw; cap the mains green.
patient | safety | Polycarbonate enclosure, 10 x 8 x 6 in, opaque hinged cover | AutomationDirect | H10086HF-6P-P10 | 1 | 107.00 | list | https://www.automationdirect.com/pn/H10086HF-6P-P10 | Patient-cart box for the supply and the relay. One internal DIN rail.
patient | safety | DIN-rail kit for 8 in Integra Premium (pack of 2 rails) | AutomationDirect | DIN8-P10 | 1 | 21.00 | list | https://www.automationdirect.com/pn/DIN8-P10 | Use one rail. The second rail stays spare.
patient | safety | 18 AWG 4-conductor flexible control cable | AutomationDirect | PMTC-18U-4BK-1 | 50 | 0.88 | list | https://www.automationdirect.com/pn/PMTC-18U-4BK-1 | 50 ft reel, fully used: two supervisor-desk runs, three short robot pieces, supply jumpers. Price is per foot.
patient | safety | Mains cord, SJOOW 18 AWG, 3 conductors, black/white/green | AutomationDirect | H11131803-1 | 20 | 0.72 | list | https://www.automationdirect.com/pn/H11131803-1 | 20 ft is the catalog minimum. Black to supply L | white to N | green taped. Price is per foot. An existing black/white/green cord is electrically compatible.
patient | safety | NEMA 5-15P plug, 15 A, 125 V | AutomationDirect | BRY5266NP | 1 | 13.00 | list | https://www.automationdirect.com/pn/BRY5266NP | Plug end: black brass | white silver | green to the green screw.
tower | energy | Electrosurgical unit, monopolar + bipolar | DRE (used) | ASG-300 | 1 | 1200.00 | used |  | Bought used on eBay, research use only (PI, 2026-11-02). Interfaced through the first-party ESU-TAP interposer below.
tower | energy | ESU-TAP PCB interposer with ESP32 (micro-ROS) | ARTS (first-party) | arts-esu-tap | 1 | 62.22 | list |  | Custom. Sense-then-forward footswitch plus software energy activation; both logged. Board revision v2. 62.22 = JLCPCB public online price 2026-11-02 (bare PCB 1.008 + SMD assembly incl. parts 20.388; the LCSC-numbered SMD BOM ships with the board design) + hand-installed and panel parts at DigiKey qty-1 list 2026-11-02, 40.82: ESP32-DevKitC-32E 10.00; Phoenix 1715747 (MKDS 1,5/4-5,08) 2x2.28; Phoenix 1715734 (MKDS 1,5/3-5,08) 2x1.71; Same Sky PJ-102AH 0.83; TE 206430-1 panel receptacle 2x6.06; TE 66105-4 socket contact 8x2.00. No enclosure: the board runs bare, as the camera sync box does. The 5 V supply is the next row. Still to confirm: whether the 20.388 assembly figure already includes the PCB is to be confirmed.
tower | energy | 5 V wall adapter for the ESU-TAP relay rail (5.5 x 2.1 mm barrel, centre positive) | Same Sky (Bel Power Solutions) | SWI12-5-N-P5 | 1 | 20.51 | list | https://www.digikey.com/en/products/result?keywords=SWI12-5-N-P5 | Any regulated 5 V, >= 1 A, centre-positive 5.5 x 2.1 mm adapter works: the six 5 V relay coils draw well under 1 A, and the ESP32 is powered over USB. DigiKey qty-1 price 2026-11-02; stock and plug details not confirmed on the page, so check them when ordering.
tower | structure | Laparoscopic video tower cart | Karl Storz (used) | TBD | 1 | 250.00 | used |  | Used, bought on eBay for 250.00 (PI, 2026-11-02); carries monitor 4 (tower view) and the support equipment. Any equivalent cart works.
tower | display | Monitor 4 (tower view), on the tower cart | Amazon | B0CMXK5QDD | 1 | 130.00 | estimate | https://www.amazon.com/dp/B0CMXK5QDD | How the tower monitor was acquired is not recorded; costed as the supervisor monitor model, which does the job (any HDMI 1080p 60 Hz monitor; E7 glass-to-glass was measured on the tower monitor at 60 Hz).
tower | optics | Laparoscopic light source | Luxtec (used) | LX300 | 1 | 250.00 | used |  | Bought used on eBay, research use only (PI, 2026-11-02).
tower | support | Smoke evacuator | Bovie (used) | SmokeShark II SE02 (100-120 V) | 1 | 350.00 | used | https://www.ebay.com/itm/920018283610 | Used on eBay, 349.99 rounded (PI, 2026-11-02), without filter; research use only. The filter is a consumable, next row.
tower | support | Smoke evacuator filter, 35 h | Bovie | SF35 | 1 | 243.44 | list | https://mfimedical.com/products/bovie-smoke-evacuator-filter-35-hr | Consumable, replaced as it wears; one included in the system cost (MFI Medical, new, 2026-11-02).
tower | support | Endoscopic flushing pump (irrigation) | Olympus (used) | OFP | 1 | 130.00 | used |  | Bought used on eBay, research use only (PI, 2026-11-02).
tower | support | Medical suction pump | TBD (used) | TBD | 1 | 110.00 | used | https://www.ebay.com/itm/236502488431 | Bought used on eBay, research use only (PI, 2026-11-02).
console | structure | Surgeon console frame, 80/20 40-series T-slot (extrusions, plates, fasteners, casters, HDPE panels) | 80/20 | IdeaBuilder design ARTS_Surgeon_Console_V5 | 1 | 1504.27 | list |  | 80/20 IdeaBuilder bill of materials 2026-09-23 (cut and machined parts), self-assembled. Design files machine-local for now (description catalog, 7_surgeon_console).
console | haptics | Haply Inverse3 Developer Kit (Inverse3, desk clamp, VerseGrip stylus, power adaptor, USB cables); one right- and one left-handed | Haply Robotics | Inverse3 Developer Kit | 2 | 5500.00 | quote | https://haply.co/inverse3 | Haply's standard per-kit price (5,500.00), subject to each institution's quote; Haply publishes no web price. A discount offered to the PI is not used. Includes the VerseGrip.
console | haptics | Grip add-on for the VerseGrip (uses its Hall sensor) | ARTS (first-party, collaborator A) | TBD | 2 | TBD | estimate |  | Design and parts from collaborator A, to be collected.
console | display | Stereo head-mounted display, GOOVIS G3 family (plain HDMI stereo) | GOOVIS | G3 Max | 1 | 1199.00 | list | https://goovis.com/products/goovis-g3max | GOOVIS G3 Max basic set, the unit on the console; list price 1,199.00 (goovis.com and Amazon list, 2026-11-02).
console | structure | Armrest cushion for the console arm rest | EdgeRest (Amazon) | B0FY9T1YTP | 1 | 60.00 | list | https://www.amazon.com/dp/B0FY9T1YTP | PostureUp L-shaped armrest pad (PI, 2026-11-02).
console | input | Programmable 3-pedal USB footswitch (teleop pedals) | Kinesis | Savant Elite2 FP30A | 1 | 229.00 | list | https://kinesis-ergo.com/shop/savant-elite2-triple-pedal/ | Clutch / camera / instrument switch / record marks per the input mapping file. kinesis-ergo.com 2026-11-02.
console | energy | Monopolar ESU footswitch (CUT/COAG) for the ASG-300 | Bovie (used) | BV-1253B | 1 | 499.00 | used | https://www.ebay.com/itm/154211251093 | Bought used on eBay (PI, 2026-11-02); read by the ESU-TAP board.
console | energy | Bipolar ESU footswitch for the ASG-300 | Bovie (used) | BV-1254B | 1 | 240.00 | used | https://www.ebay.com/p/706577766 | Bought used on eBay (PI, 2026-11-02).
supervisor | display | Monitors 1 and 2 (operator GUI, RViz) | Amazon | B0CMXK5QDD | 2 | 130.00 | list | https://www.amazon.com/dp/B0CMXK5QDD | The supervisor monitors (PI, 2026-11-02). Keyboard and mouse come with the main PC.
supervisor | safety | Gray 2-hole 22 mm button box, ARM HOLD plus RESET | AutomationDirect | SA106-40SL | 1 | 11.50 | list | https://www.automationdirect.com/pn/SA106-40SL | The single ARM HOLD station at the supervisor desk. NC blocks side by side.
supervisor | safety | Blue 22 mm latching button, ARM HOLD | AutomationDirect | GCX3194-24L | 1 | 25.00 | list | https://www.automationdirect.com/pn/GCX3194-24L | Remove the stock NO block. Fit two NC blocks side by side.
supervisor | safety | NC contact block pack of 2 | AutomationDirect | ECX1030-2 | 1 | 8.75 | list | https://www.automationdirect.com/pn/ECX1030-2 | One pack gives the two NC blocks for the blue button.
supervisor | safety | Legend plate OFF-ON | AutomationDirect | ECX1670-B16 | 1 | 3.50 | list | https://www.automationdirect.com/pn/ECX1670-B16 | Overlay ARM HOLD. Do not use a red STOP legend.
supervisor | safety | Green 22 mm momentary button, RESET, 1 NO | AutomationDirect | GCX3102 | 1 | 5.75 | list | https://www.automationdirect.com/pn/GCX3102 | Keep its stock NO block.
supervisor | safety | Legend plate RESET | AutomationDirect | ECX1670-B38 | 1 | 4.50 | list | https://www.automationdirect.com/pn/ECX1670-B38
lab | structure | Supervisor table | any | TBD | 1 | TBD | TBD |  | Any table; standard furniture a lab already has, NOT in the system cost (PI, 2026-11-02).
lab | environment | Laparoscopic trainer box | Karl Storz | TBD | 1 | TBD | TBD |  | Standard lab equipment a surgical-robotics group already has; listed so the setup is complete, NOT in the system cost (PI, 2026-11-02).
lab | environment | Cannula / trocar | TBD | TBD | 3 | TBD | TBD |  | Standard lab equipment a surgical-robotics group already has; listed so the setup is complete, NOT in the system cost (PI, 2026-11-02).
lab | metrology | fusionTrack optical tracker | Atracsys | TBD | 1 | TBD | TBD |  | NOT part of the ARTS build. Used only for the external ground-truth accuracy session; exclude from the system cost total.
lab | metrology | High-speed camera (240 fps) for the latency rig | TBD | TBD | 1 | TBD | TBD |  | NOT part of the ARTS build. A modern phone at 240 fps is sufficient.
