MRE-Lab-UMD/arts/hardware/laparoscope/printed/prism_mount_bottom.stl

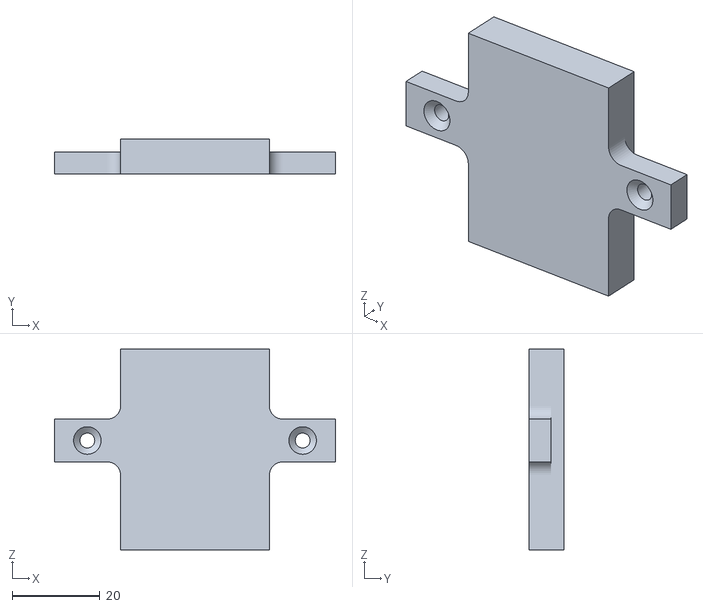
[picture p3: CAD file, 2026-11-10]
hardware/laparoscope/printed/prism_mount_bottom.stl
64.2 x 7.93 x 45.9
