MRE-Lab-UMD/arts/hardware/tool_adapter/machined/inner_shaft.step

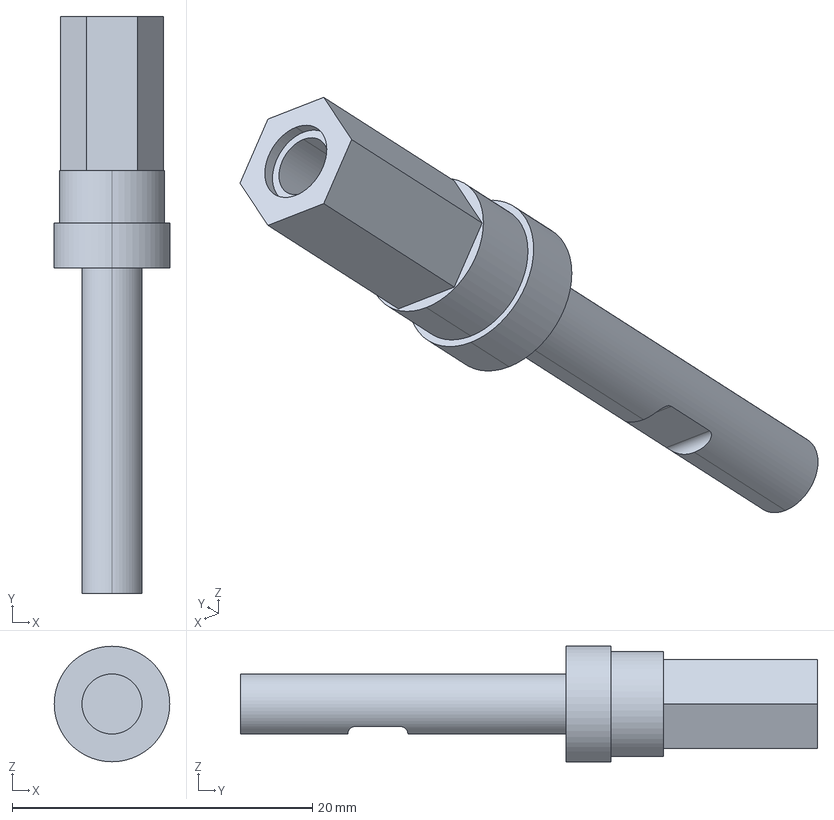
[picture p4: CAD file, 2026-11-10]
hardware/tool_adapter/machined/inner_shaft.step
7.70 x 38.4 x 7.70 mm
