MRE-Lab-UMD/arts/hardware/tool_adapter/printed/06_Snap_Clips.stl

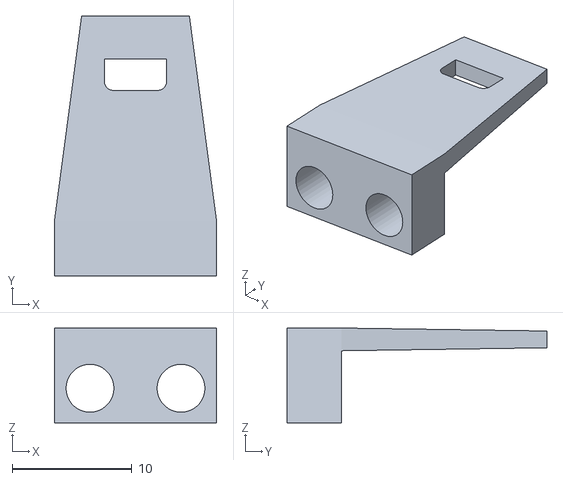
[picture p5: CAD file, 2026-11-10]
hardware/tool_adapter/printed/06_Snap_Clips.stl
13.6 x 21.7 x 7.93
