MRE-Lab-UMD/arts/hardware/laparoscope/printed/prism_mount_top.stl

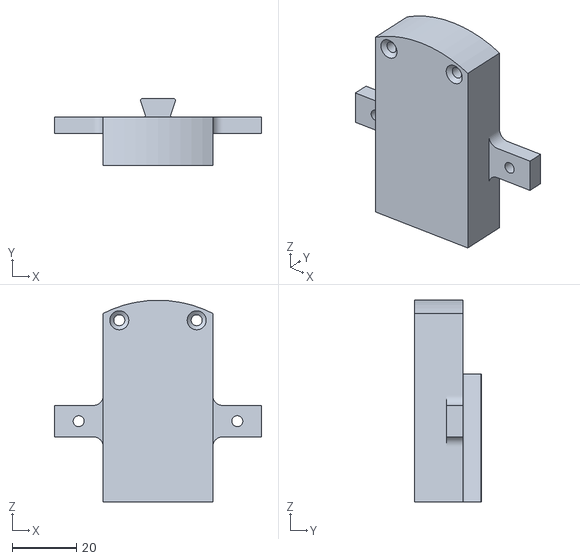
[picture p6: CAD file, 2026-11-10]
hardware/laparoscope/printed/prism_mount_top.stl
64.2 x 20.7 x 62.5
