MRE-Lab-UMD/arts/hardware/tool_adapter/machined/outer_shaft.step

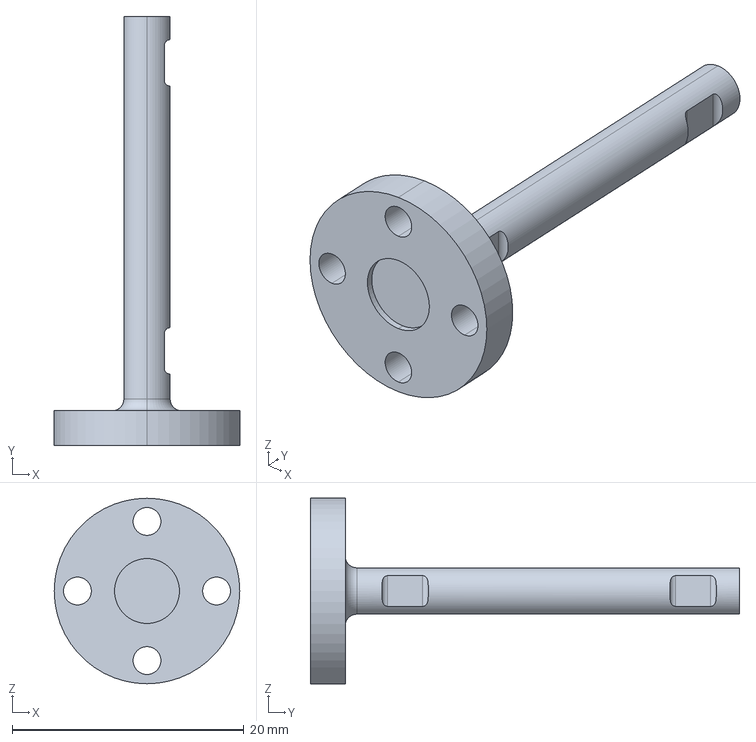
[picture p7: CAD file, 2026-11-10]
hardware/tool_adapter/machined/outer_shaft.step
16.0 x 37.0 x 16.0 mm
