MRE-Lab-UMD/arts/hardware/tool_adapter/printed/OPTIONAL_03_Top_Securing_Forceps_Scissors.stl

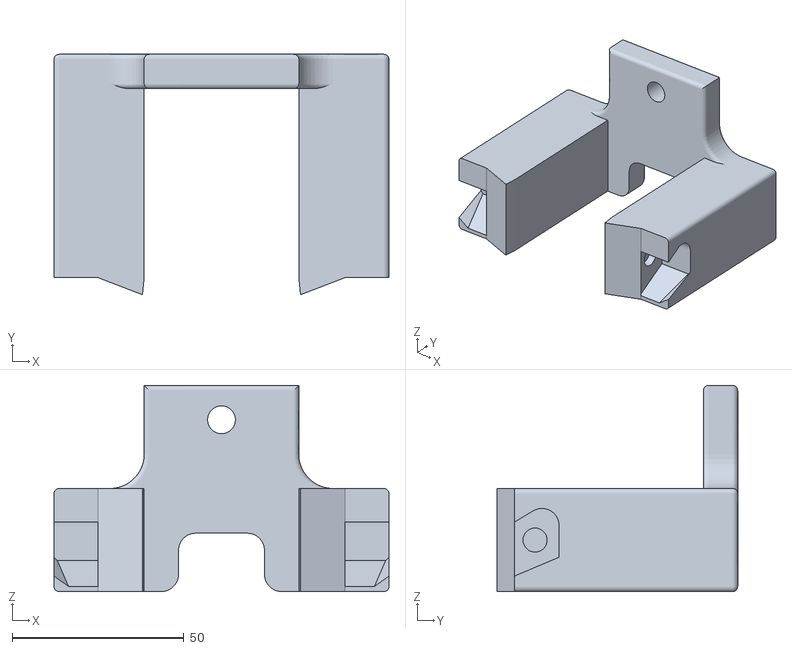
[picture p8: CAD file, 2026-11-10]
hardware/tool_adapter/printed/OPTIONAL_03_Top_Securing_Forceps_Scissors.stl
97.5 x 70.0 x 60.0
