MRE-Lab-UMD/arts/hardware/laparoscope/printed/adapter_for_light_cable_mount.stl

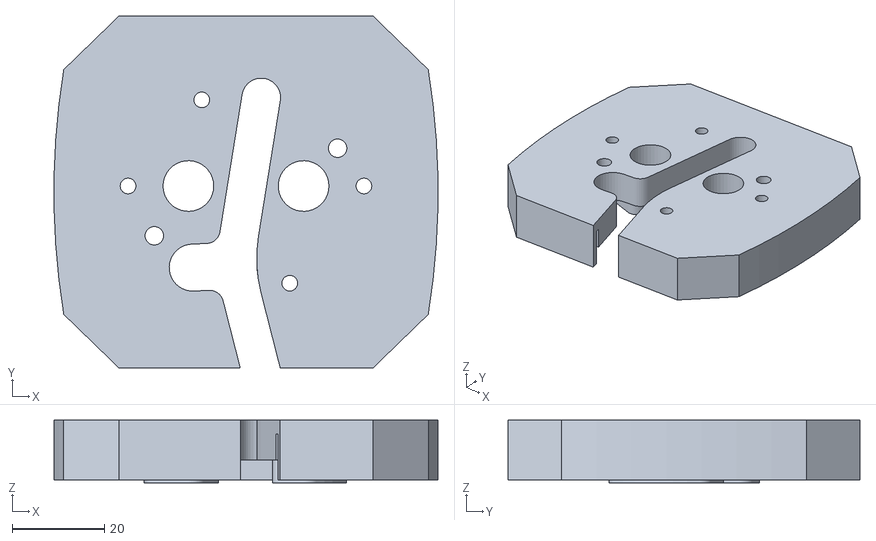
[picture p9: CAD file, 2026-11-10]
hardware/laparoscope/printed/adapter_for_light_cable_mount.stl
83.3 x 76.4 x 13.6
