MRE-Lab-UMD/arts/hardware/tool_adapter/printed/22_Motor_Twist_Top.stl

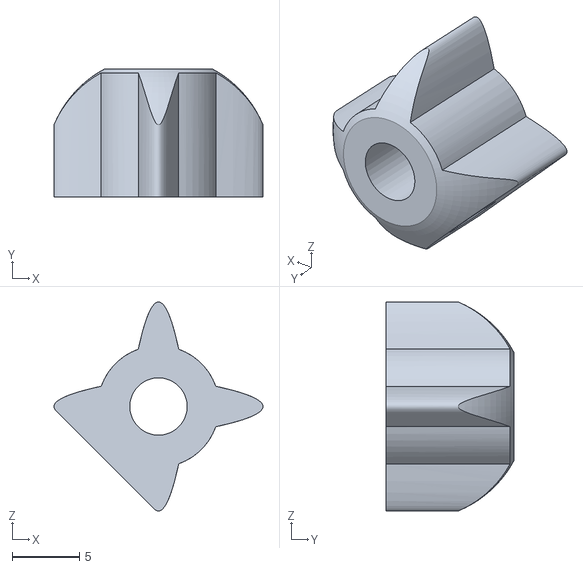
[picture p10: CAD file, 2026-11-10]
hardware/tool_adapter/printed/22_Motor_Twist_Top.stl
15.5 x 9.50 x 15.5
