MRE-Lab-UMD/arts/hardware/laparoscope/printed/prism_mount_left_plate.stl

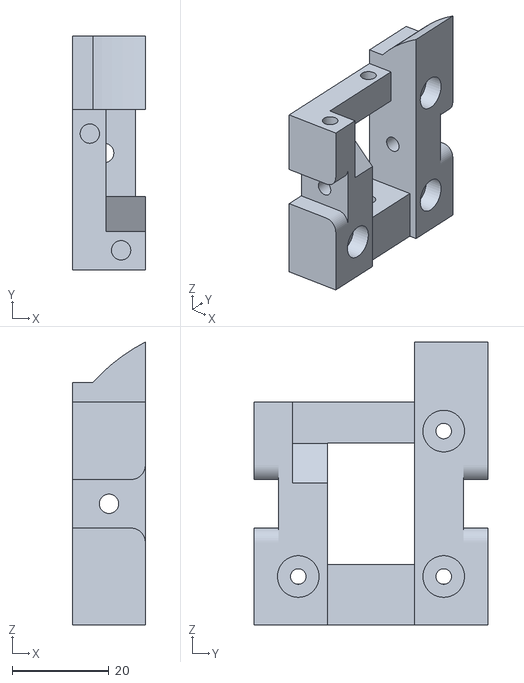
[picture p11: CAD file, 2026-11-10]
hardware/laparoscope/printed/prism_mount_left_plate.stl
15.0 x 48.3 x 58.4
