MRE-Lab-UMD/arts/hardware/laparoscope/printed/ur5_mount.stl

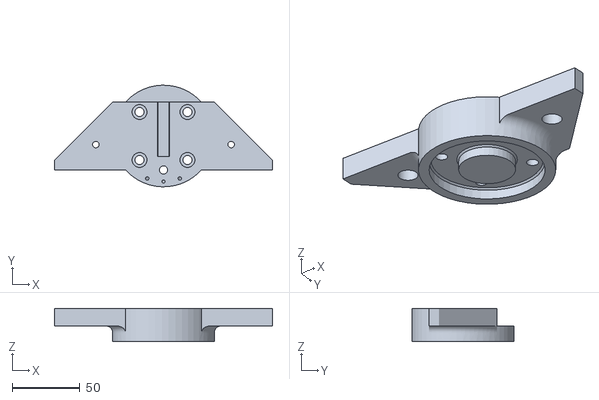
[picture p13: CAD file, 2026-11-10]
hardware/laparoscope/printed/ur5_mount.stl
160.7 x 75.0 x 24.5
