MRE-Lab-UMD/arts/hardware/tool_adapter/printed/OPTIONAL_13_Rod_Support_Base_Clip_stapler.stl

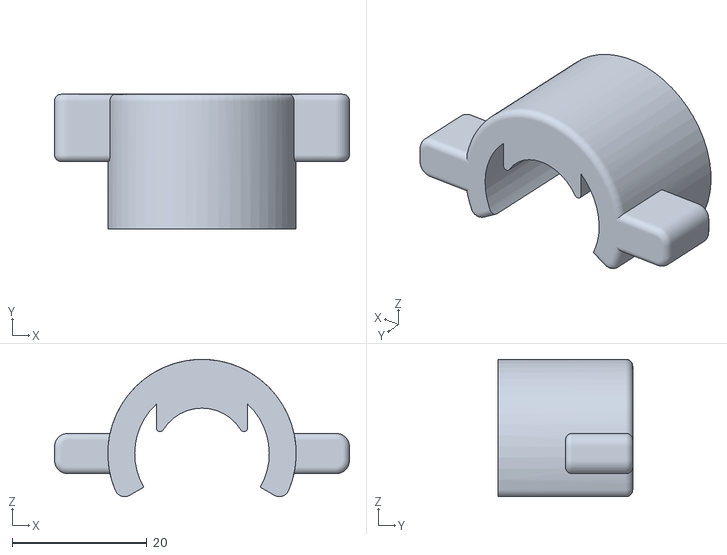
[picture p14: CAD file, 2026-11-10]
hardware/tool_adapter/printed/OPTIONAL_13_Rod_Support_Base_Clip_stapler.stl
43.8 x 20.0 x 20.4
