MRE-Lab-UMD/arts/hardware/tool_adapter/printed/04_Disk_Plate_0.5.stl

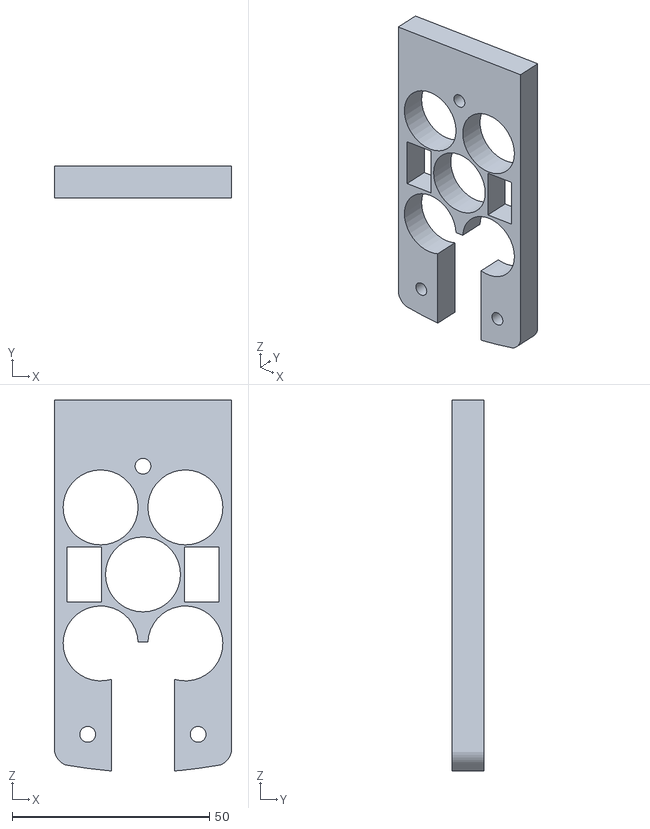
[picture p15: CAD file, 2026-11-10]
hardware/tool_adapter/printed/04_Disk_Plate_0.5.stl
45.0 x 8.10 x 94.1
