MRE-Lab-UMD/arts/hardware/laparoscope/printed/light_cable_holder_left.stl

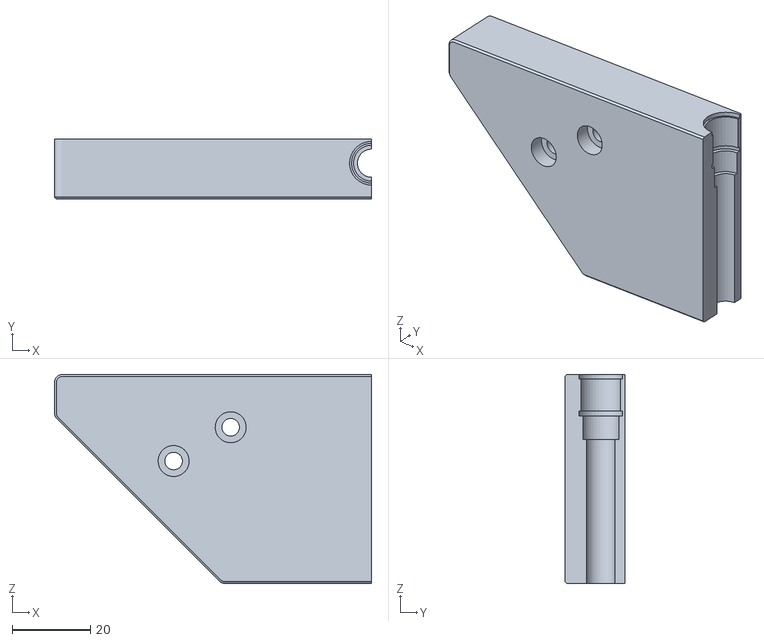
[picture p16: CAD file, 2026-11-10]
hardware/laparoscope/printed/light_cable_holder_left.stl
81.1 x 15.4 x 53.5
