MRE-Lab-UMD/arts/hardware/tool_adapter/printed/05_Engagement_Disks.stl

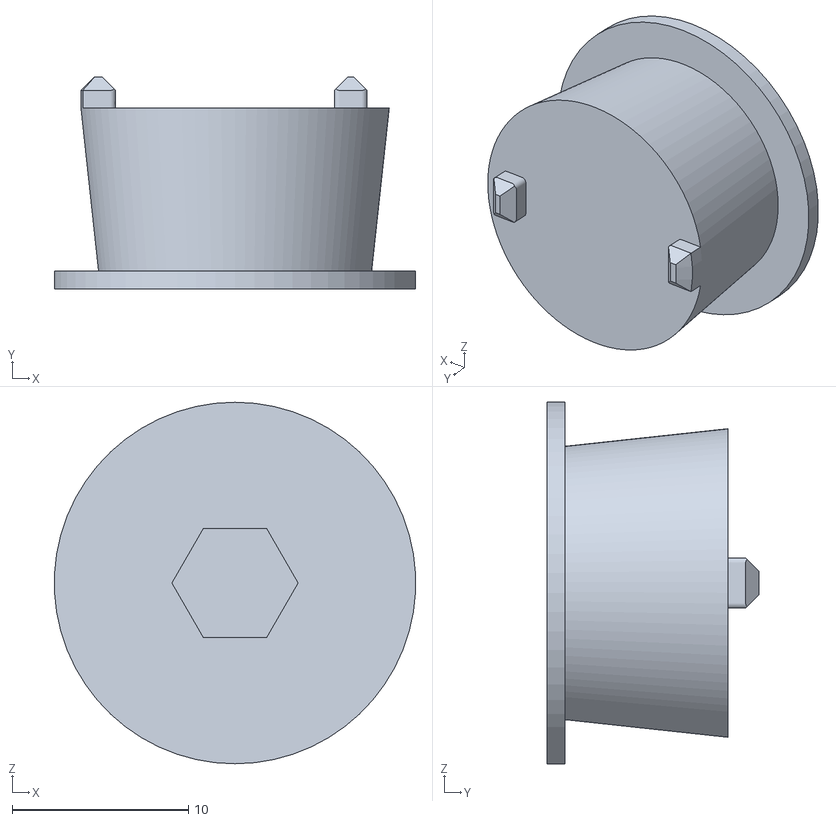
[picture p17: CAD file, 2026-11-10]
hardware/tool_adapter/printed/05_Engagement_Disks.stl
20.5 x 12.0 x 20.5
