MRE-Lab-UMD/arts/hardware/laparoscope/printed/light_cable_holder_right.stl

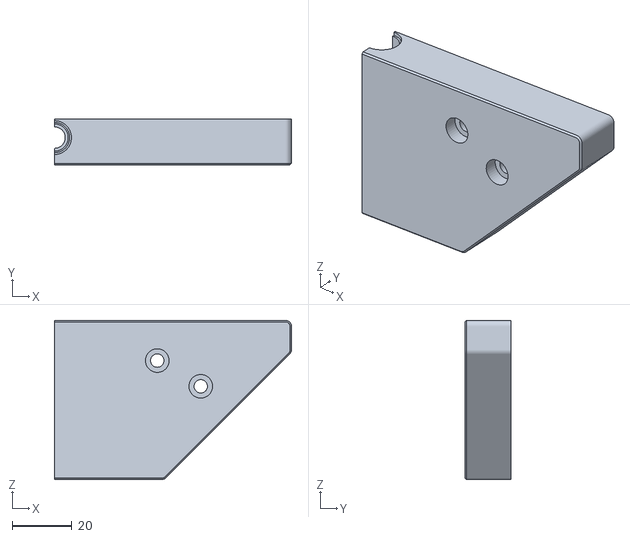
[picture p18: CAD file, 2026-11-10]
hardware/laparoscope/printed/light_cable_holder_right.stl
79.6 x 15.4 x 53.5
