MRE-Lab-UMD/arts/hardware/tool_adapter/printed/17_Motor_Holder_Outer.stl

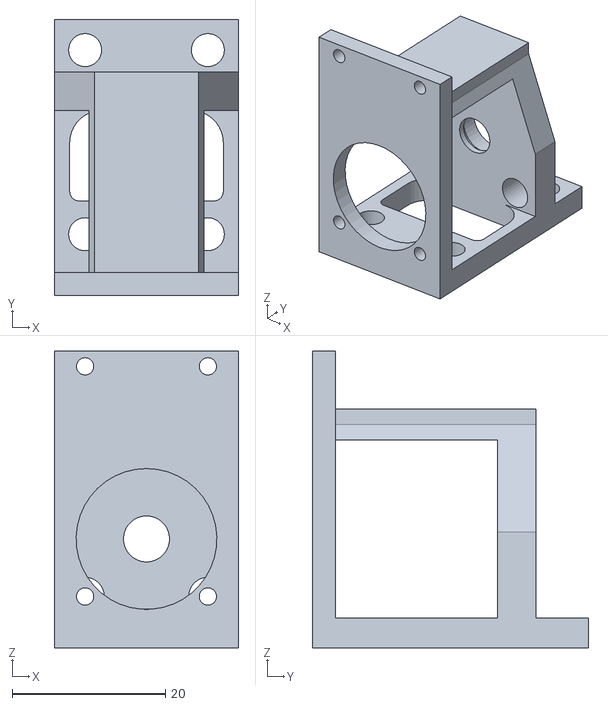
[picture p19: CAD file, 2026-11-10]
hardware/tool_adapter/printed/17_Motor_Holder_Outer.stl
24.0 x 36.0 x 38.7
