MRE-Lab-UMD/arts/hardware/laparoscope/printed/prism_mount_back.stl

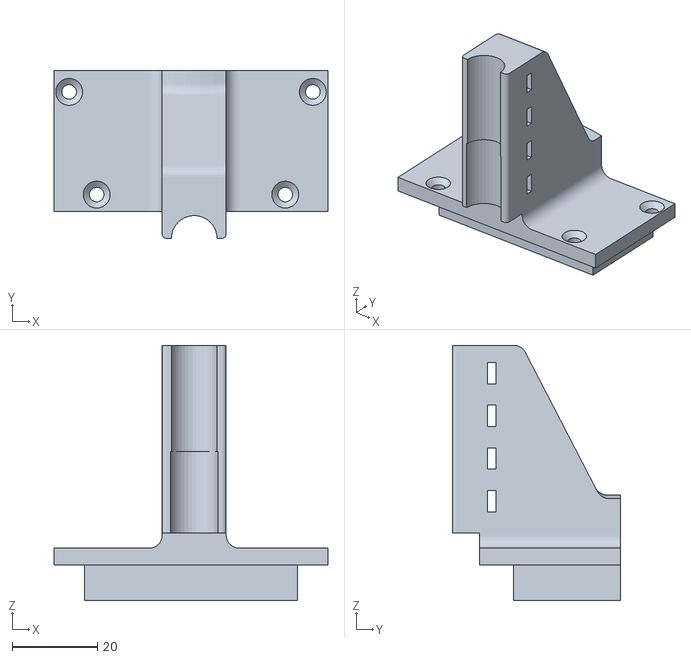
[picture p20: CAD file, 2026-11-10]
hardware/laparoscope/printed/prism_mount_back.stl
64.2 x 39.3 x 59.8
