MRE-Lab-UMD/arts/hardware/tool_adapter/printed/02_UR_Connector_top.stl

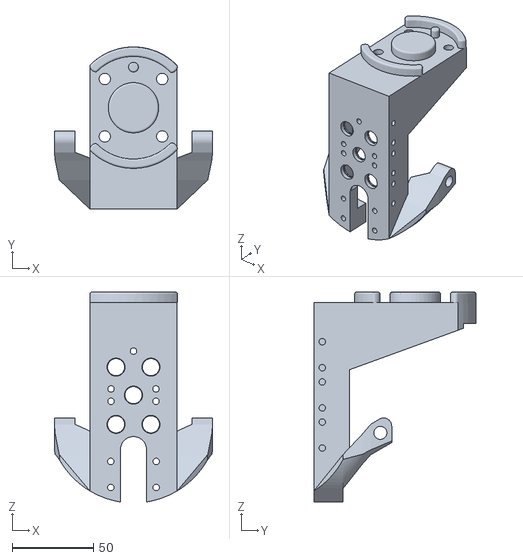
[picture p21: CAD file, 2026-11-10]
hardware/tool_adapter/printed/02_UR_Connector_top.stl
97.5 x 100.0 x 129.4
