MRE-Lab-UMD/arts/hardware/tool_adapter/printed/OPTIONAL_14mm_Tool_Support_Channel_Stapler.stl

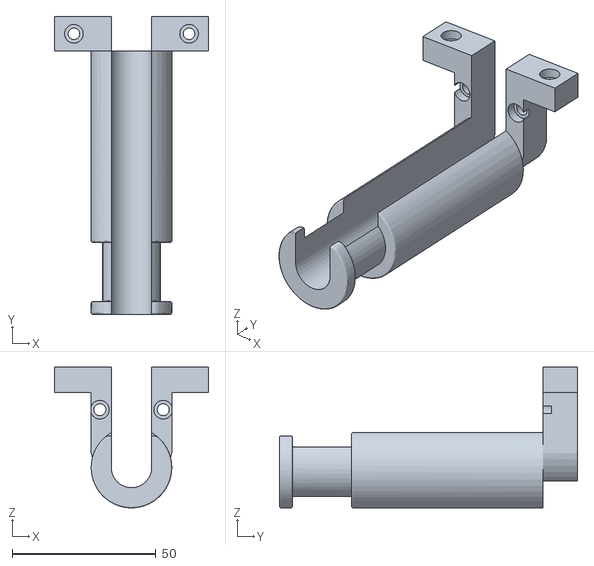
[picture p22: CAD file, 2026-11-10]
hardware/tool_adapter/printed/OPTIONAL_14mm_Tool_Support_Channel_Stapler.stl
53.6 x 103.5 x 48.9
