MRE-Lab-UMD/arts/hardware/tool_adapter/printed/16_U2D2_Board_Holder.stl

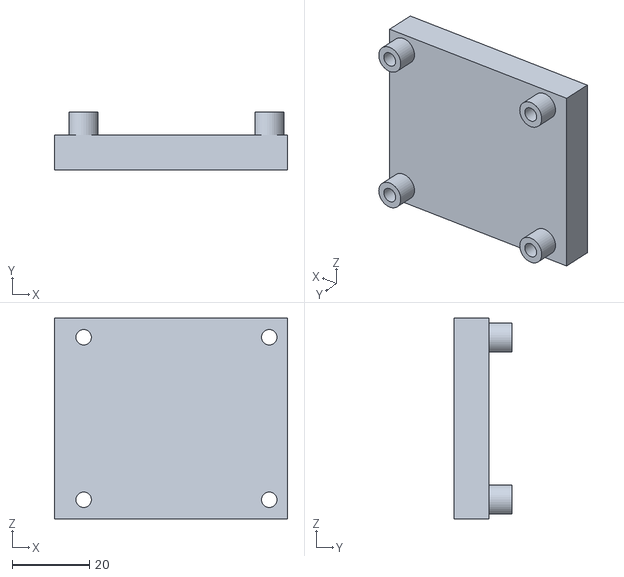
[picture p23: CAD file, 2026-11-10]
hardware/tool_adapter/printed/16_U2D2_Board_Holder.stl
60.3 x 15.0 x 52.0
