MRE-Lab-UMD/arts/hardware/tool_adapter/printed/OPTIONAL_03_Top_Securing_stapler.stl

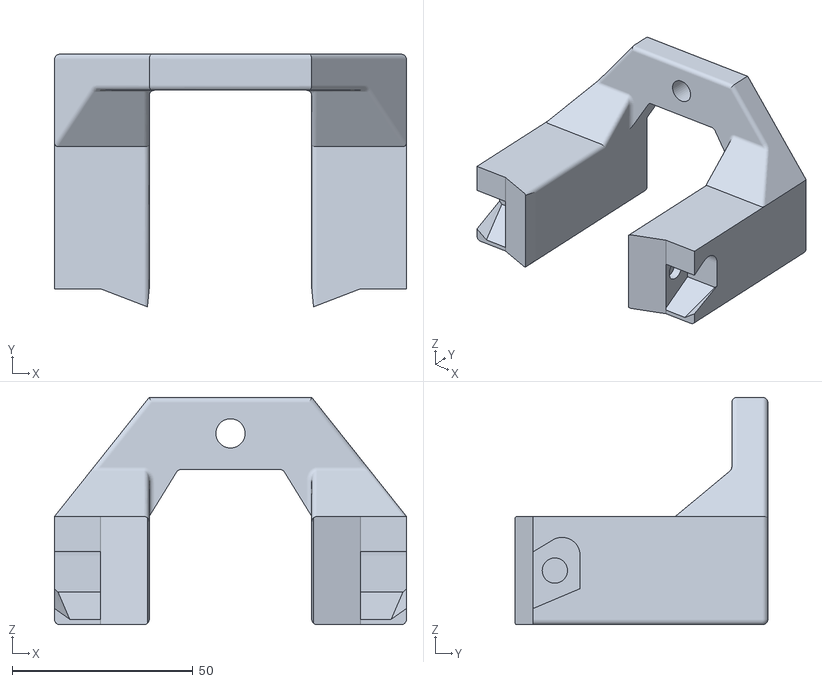
[picture p24: CAD file, 2026-11-10]
hardware/tool_adapter/printed/OPTIONAL_03_Top_Securing_stapler.stl
97.5 x 70.0 x 63.0
