MRE-Lab-UMD/arts/hardware/tool_adapter/printed/13_8mm_Clip.stl

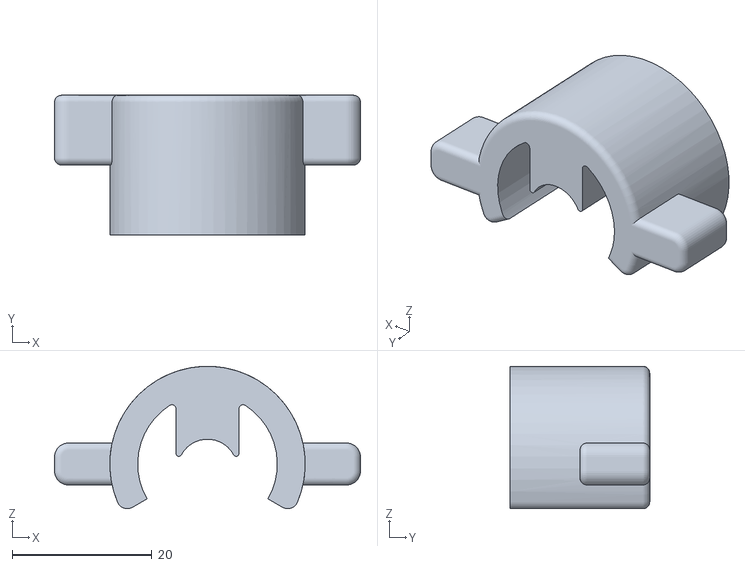
[picture p25: CAD file, 2026-11-10]
hardware/tool_adapter/printed/13_8mm_Clip.stl
43.8 x 20.0 x 20.4
