MRE-Lab-UMD/arts/(list of files, cad)

Other CAD files:
hardware/laparoscope/printed/prism_mount_right_plate.stl
hardware/tool_adapter/printed/8mm_Tool_Support_Channel.stl
