MRE-Lab-UMD/arts/docs/benchmarks/flir_bfs-u3-63s4c_20260806.md

# FLIR Camera Benchmark Report

**Date:** 2026-08-06 07:11 UTC
**Camera:** FLIR Blackfly S BFS-U3-63S4C (USB3)
**Docker image digest:** `sha256:7365f6bd964295866981f3307893cd475096319b5778f13db077f91da38ef618`
**Bag size:** 26368.78 MB

## `/bench_camera/image_raw`

| Metric | Value |
|---|---|
| Nominal rate | 40.0 Hz |
| Measured rate | 39.99 &plusmn; 0.0 Hz (100.0% of nominal) |
| Rate range | [39.85, 40.02] Hz |
| Period | 25.004 &plusmn; 0.002 ms |
| Total frames | 23972 |
| Duration | 599.375 s |
| Drops | 0 (gap threshold: 37.5 ms) |
| Disk throughput | 43.99 MB/s |

## Resource usage (container)

| Metric | Value |
|---|---|
| CPU mean | 125.9% |
| CPU peak | 152.9% |
| Memory mean | 1.9% |
| Memory peak | 2.4% (755.6MiB / 31.13GiB) |
| Stat samples | 101 (5 s interval) |

## Acceptance criteria

- **`/bench_camera/image_raw`**
  - Rate >= 99% of nominal: **PASS** (100.0%)
  - Zero drops: **PASS** (0 drops)

**Overall: PASS**
