MRE-Lab-UMD/arts/docs/benchmarks/flir_bfs-u3-63s4c_20260810.md

# FLIR Camera Benchmark Report

**Date:** 2026-08-10 15:23 UTC
**Camera:** FLIR Blackfly S BFS-U3-63S4C (USB3)
**Docker image digest:** `sha256:350845b4b901d4e5845c9d2e05e5870780994a62a6e45c62f64ae0329d5e5f87`
**Bag size:** 23816.8 MB

## Host configuration

| Setting | Value |
|---|---|
| Kernel | 6.8.1-1057-realtime (PREEMPT_RT) |
| CPU | Intel(R) Core(TM) i7-9750H CPU @ 2.60GHz (12 logical, 8 available after isolation) |
| Isolated CPUs | 4-5,10-11 |
| NVIDIA driver | 595.84 |
| net.core.rmem_max | 26214400 |
| usbfs_memory_mb | 1000 |
| Docker | 29.7.2 |

## `/bench_camera/image_raw`

| Metric | Value |
|---|---|
| Nominal rate | 40.0 Hz |
| Measured rate | 39.99 &plusmn; 0.0 Hz (100.0% of nominal) |
| Rate range | [39.94, 40.01] Hz |
| Period | 25.004 &plusmn; 0.002 ms |
| Total frames | 23967 |
| Duration | 599.249 s |
| Drops | 0 (gap threshold: 37.5 ms) |
| Disk throughput | 39.74 MB/s |

## Resource usage (container)

| Metric | Value |
|---|---|
| CPU mean | 110.6% |
| CPU peak | 150.1% |
| Memory mean | 2.0% |
| Memory peak | 2.8% (905.4MiB / 31.13GiB) |
| Stat samples | 101 (5 s interval) |

## Acceptance criteria

- **`/bench_camera/image_raw`**
  - Rate >= 99% of nominal: **PASS** (100.0%)
  - Zero drops: **PASS** (0 drops)

**Overall: PASS**

## Comparison with the Humble baseline (2026-08-06)

Same two cameras (serials 24057131 / 24057132), same 40 fps single-camera protocol, same
10-minute duration. What changed underneath: Ubuntu 22.04 → 24.04, ROS 2 Humble → Jazzy,
generic kernel → 6.8.1-1057-realtime with `isolcpus=4,5,10,11`, and MCAP went from an
explicitly selected storage plugin to Jazzy's default.

| Metric | Humble (20260806) | Jazzy (20260810) |
|---|---|---|
| Measured rate | 39.99 ± 0.0 Hz (100.0%) | 39.99 ± 0.0 Hz (100.0%) |
| Drops | 0 | 0 |
| Total frames | 23972 | 23967 |
| CPU mean | 125.9% | 110.6% |
| CPU peak | 152.9% | 150.1% |
| Memory peak | 755.6 MiB | 905.4 MiB |
| Bag size | 26368.8 MB | 23816.8 MB |

The metrics that gate acceptance — rate and drops — are identical, which is the result that
matters: the Jazzy migration costs nothing on the camera path.

The secondary numbers moved and none of the movement is interpretable as a regression. Bag
size is scene-dependent because Zstd compresses image content, and the two runs filmed
different scenes, so a 10% difference says nothing about the stack. Memory is higher and CPU
lower, which is consistent with different buffering behaviour, but with one sample per
configuration neither is evidence of anything. Treat rate and drops as the comparison and the
rest as recorded context.

Note the CPU percentages are of a single core (Docker convention), measured on a host with
four of twelve logical CPUs isolated away from general scheduling.
