MRE-Lab-UMD/arts/arts_ros2_ws/src/arts_embedded/arts_camera_sync/hardware/arts-camera-sync-v2/arts-camera-sync-v2.kicad_pcb

## KiCad design arts_ros2_ws/src/arts_embedded/arts_camera_sync/hardware/arts-camera-sync-v2/arts-camera-sync-v2.kicad_pcb (2026-11-10)

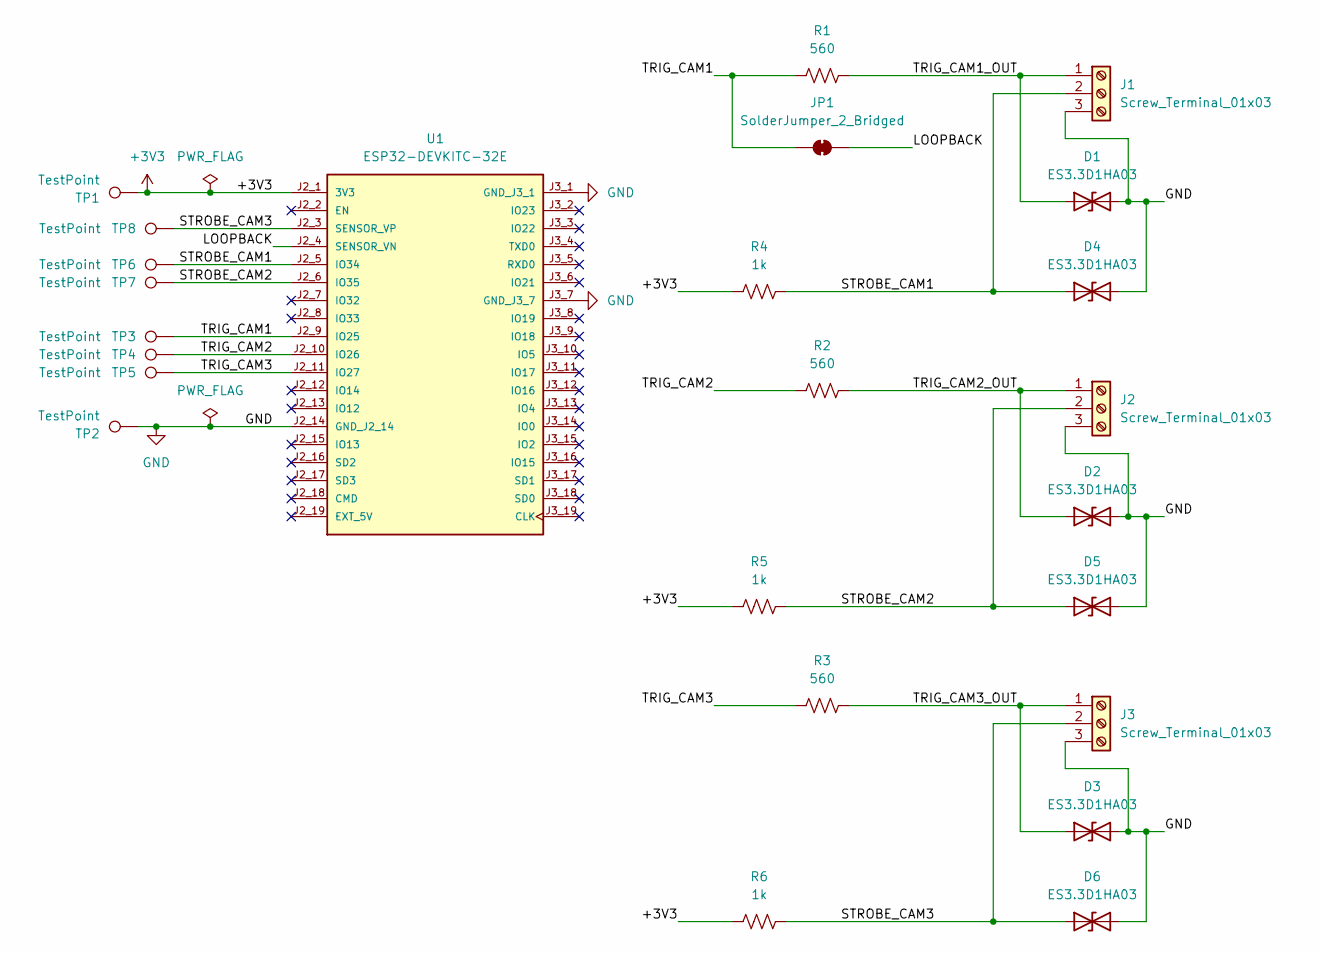
[picture p27: schematic arts-camera-sync-v2.kicad_sch]

Parts:
D1, D2, D3, D4, D5, D6: ES3.3D1HA03; D_SOD-323
J1, J2, J3: Screw_Terminal_01x03; TerminalBlock_Phoenix_MKDS-1,5-3-5.08_1x03_P5.08mm_Horizont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
JP1: SolderJumper_2_Bridged; SolderJumper-2_P1.3mm_Bridged_RoundedPad1.0x1.5mm
R1, R2, R3: 560; R_0402_1005Metric
R4, R5, R6: 1k; R_0402_1005Metric
TP1, TP2, TP3, TP4, TP5, TP6, TP7, TP8: TestPoint; TestPoint_Pad_D1.0mm
U1: ESP32-DEVKITC-32E; MODULE_ESP32-DEVKITC-32E; PARTREV 1.4

Connections:
+3V3: R4.1, R5.1, R6.1, TP1.1, U1.J2_1 (3V3)
/LOOPBACK: JP1.2 (B), U1.J2_4 (SENSOR_VN)
/STROBE_CAM1: D4.1 (A1), J1.2, R4.2, TP6.1, U1.J2_5 (IO34)
/STROBE_CAM2: D5.1 (A1), J2.2, R5.2, TP7.1, U1.J2_6 (IO35)
/STROBE_CAM3: D6.1 (A1), J3.2, R6.2, TP8.1, U1.J2_3 (SENSOR_VP)
/TRIG_CAM1: JP1.1 (A), R1.1, TP3.1, U1.J2_9 (IO25)
/TRIG_CAM1_OUT: D1.1 (A1), J1.1, R1.2
/TRIG_CAM2: R2.1, TP4.1, U1.J2_10 (IO26)
/TRIG_CAM2_OUT: D2.1 (A1), J2.1, R2.2
/TRIG_CAM3: R3.1, TP5.1, U1.J2_11 (IO27)
/TRIG_CAM3_OUT: D3.1 (A1), J3.1, R3.2
GND: D1.2 (A2), D2.2 (A2), D3.2 (A2), D4.2 (A2), D5.2 (A2), D6.2 (A2), J1.3, J2.3, J3.3, TP2.1, U1.J2_14 (GND_J2_14), U1.J3_1 (GND_J3_1), U1.J3_7 (GND_J3_7)

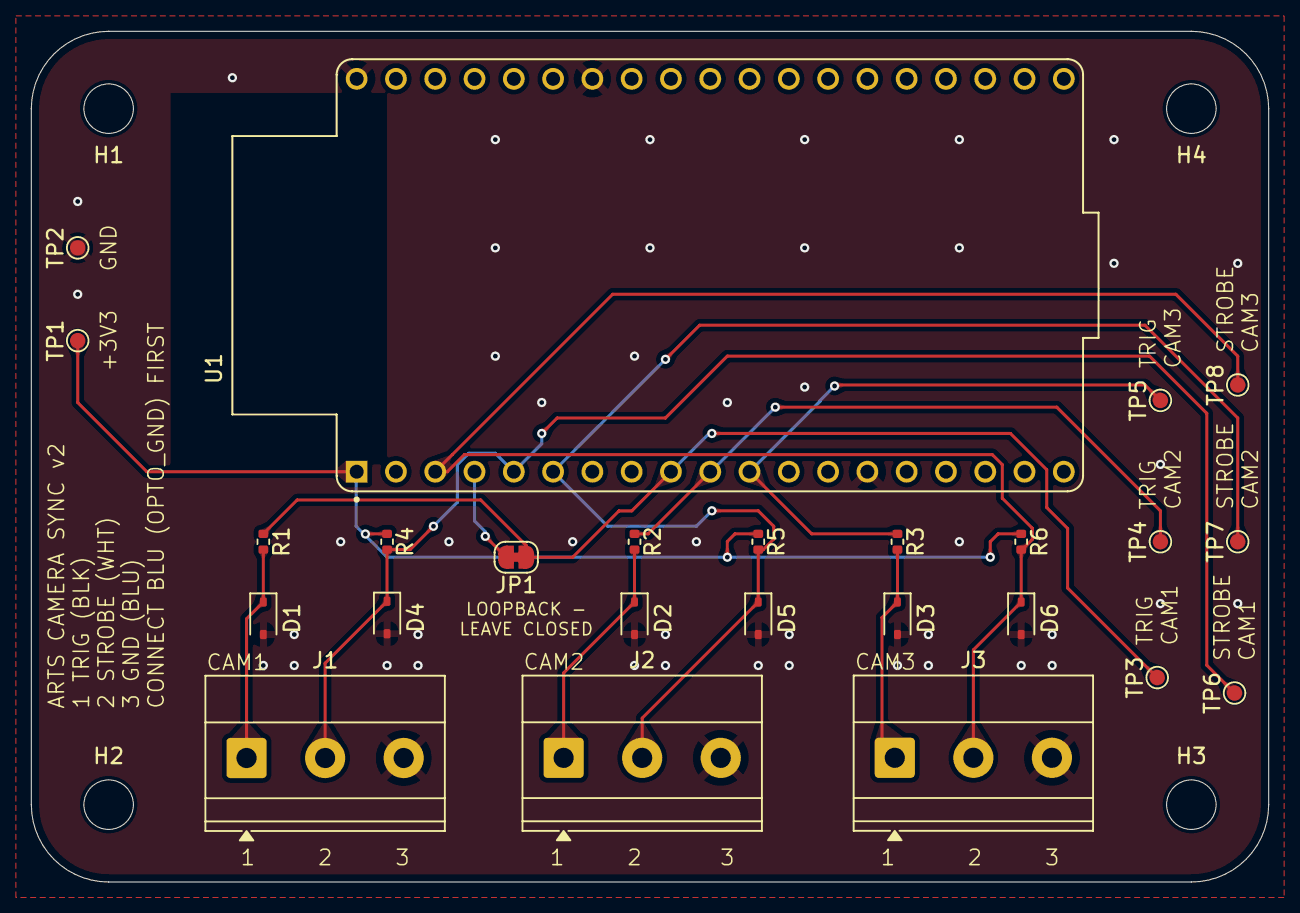
[picture p28: board arts-camera-sync-v2.kicad_pcb from above]

Board: 2 copper layers, 80.0 x 55.0 mm, 29 parts (0 on the bottom side), 12 nets.

Other parts of the board:
H1, H2, H3, H4: MountingHole_3.2mm_M3_DIN965_Pad; MountingHole_3.2mm_M3
