MRE-Lab-UMD/arts/arts_ros2_ws/src/arts_embedded/arts_dv_tool_driver/include/arts_dv_tool_driver/homing/dxl_interface.hpp

// -------------------------------------------------------------- //
// Interface to dynamixel using dynamixel_sdk
//
// Last Update : 20251219
//
// -------------------------------------------------------------- //

//changes at 47,140

#ifndef DXL_INTERFACE_H
#define DXL_INTERFACE_H

//#include "arts_homing/visibility_control.h"

#include <string>
#include <vector>
#include <memory>

// headers for dynamixel_sdk
#include <dynamixel_sdk/dynamixel_sdk.h>		 // Uses Dynamixel SDK library that is installed with the ROS


// Control table address and byte length for Dynamixel XC330-M288
#define ADDR_GOAL_POSITION          116 // Between min/max position limit stored in address 52/48, unit: encoder pulse
#define LEN_GOAL_POSITION           4

#define ADDR_GOAL_VELOCITY          104 // Between -/+ velocity limit stored in address 44, unit: 0.229 rev/min
#define LEN_GOAL_VELOCITY           4

#define ADDR_PRESENT_POSITION       132 // unit: encoder pulse
#define LEN_PRESENT_POSITION        4   // unit: encoder pulse

#define ADDR_TORQUE_ENABLE          64  // Torque enable flag
#define LEN_TORQUE_ENABLE           1

#define ADDR_OPMODE                 11 
#define LEN_OPMODE                  1
#define OPMODE_CURRENT_CTRL         0
#define OPMODE_VELOCITY_CTRL        1   // Formerly wheel mode
#define OPMODE_POSITION_CTRL        3
#define OPMODE_EXTPOS_CTRL          4   // Extended position control (multi turn)
#define OPMODE_POSCURR_CTRL         5   // Current based position control
#define OPMODE_PWM_CTRL             16

#define ADDR_PRESENT_CURRENT        126
#define LEN_PRESENT_CURRENT         2

//CHANGE
#define ADDR_GOAL_CURRENT	    102
#define LEN_GOAL_CURRENT            2

#define ADDR_PROFILE_VELOCITY       112      
#define LEN_PROFILE_VELOCITY        4

// // // Control table address
// // #define ADDR_MX_TORQUE_ENABLE           24                  // Control table address is different in Dynamixel model
// #define ADDR_MX_GOAL_POSITION           30
// // #define ADDR_MX_PRESENT_POSITION        36
// #define ADDR_CW_ANGLE_LIM               6                   // Set this to 4095 to enable multiturn
// #define ADDR_CCW_ANGLE_LIM              8                   // Set this to 4095 to enable multiturn
// // #define ADDR_ANGLE_DIVIDER              22
// #define ADDR_DIP_GAIN                   26
// // #define ADDR_MOVING_SPEED               32

// // // Data Byte Length
// #define LEN_MX_GOAL_POSITION            2
// // #define LEN_MX_PRESENT_POSITION         2
// #define LEN_CW_ANGLE_LIM                2
// // #define LEN_ANGLE_DIVIDER               1
// #define LEN_DIP_GAIN                    3                   // 1 byte per each D,I,P Gain
// // #define LEN_MOVING_SPEED                2


// //X-Series Control Table Addresses
// #define ADDR_MX_TORQUE_ENABLE           64
// #define ADDR_OPERATING_MODE             11
// #define ADDR_MOVING_SPEED               104 //Goal Velocity in X-Series
// #define ADDR_MX_PRESENT_POSITION        132
// #define ADDR_PRESENT_CURRENT            126

// //X-Series Data Byte Lengths
// #define LEN_MX_TORQUE_ENABLE            1
// #define LEN_OPERATING_MODE              1
// #define LEN_MOVING_SPEED                4   //X-Series uses 4 bytes for velocity
// #define LEN_MX_PRESENT_POSITION         4
// #define LEN_PRESENT_CURRENT             2



// Protocol version
// #define PROTOCOL_VERSION                1.0                 // See which protocol version is used in the Dynamixel

// Default setting
// #define BAUDRATE                        1000000

#define TORQUE_ENABLE                   1                   // Value for enabling the torque
#define TORQUE_DISABLE                  0                   // Value for disabling the torque
#define MULTITURN_ENABLE                4095

// tty means TeleTYpewriter, which used to be the input output 'terminals'
// of the computers system in the past. Now, it refers to the general 'terminals' of the device.
// Change this definition for the correct port. We will be using terminal of the COM port.
//#define MODEMDEVICE "/dev/ttyUSB0"		// This is for FTDI USB RS485 cable

namespace arts_homing
{

class DxlInterface
{
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
